alejandro11k/Democracy/README.md

# Democracy
Hardware design files and application software
