alejandro11k/Democracy/software/linux-kernel-patches/README

Apply the patch of the following git/branch

https://github.com/HiassofT/rpi-linux.git (cirrus-4.4.y)

Configure
---------

KERNEL=kernel7
make ARCH=arm CROSS_COMPILE=arm-linux-gnueabihf- bcm2709_morpheus_defconfig

Compile
-------

make ARCH=arm CROSS_COMPILE=arm-linux-gnueabihf- zImage modules dtbs

Install
-------

See https://www.raspberrypi.org/documentation/linux/kernel/building.md
