alejandro11k/Democracy/hardware/board-v1.1/MBoard-BOM.ods

Sheet: MBoard-BOM-v5
Board Qte | 10
CHF / Board | 71.232
€ / Board | 20.74
Estimation / Board | 97.157
A COMMANDER
Designator | Quantity | Total | Comment | Value | Voltage | Footprint | Description | Manufacturer | Manufacturer P/N | Mouser # | Mouser Unit Price | Mouser Total | Farnell # | Farnel Unit Price | Farnell Total | Digikey # | Digikey Unit Price € | Digikey Total €
C4, C47 | 2 | 20 | 220uF | 220uF | 10V | SM/CT_7343_12_D | Tantalum Polymer 40mOhm ESR | Panasonic | 10TPB220ML | 667-10TPB220ML | 1.46 | 29.2
C5, C15, C19, C23, C26, C30, C36 | 7 | 70 | 10uF | 10uF | 35V | SM/C_1206 | Chip Monolithic Ceramic Capacitor | muRata | GRM31CR6YA106KA12L | 81-GRM31CR6YA106KA2L | 0.168 | 11.76
C6, C13 | 2 | 20 | 4.7uF | 4.7uF | 50V | SM/C_1210 | CONDENSATEUR 4.7UF 50V X7R 1210 | KEMET | C1210C475K5RACTU | 80-C1210C475K5RAC | 0.297 | 5.94
D1, D17 | 2 | 20 | B340A |  |  | SM/D_DO214-AC (SMA) | DIODE SCHOTTKY 30V 3A SMA |  |  | 621-B340A-F | 0.328 | 6.56
D2, D3 | 2 | 20 | HSMG-A100-J02J1 | Green | 2,2V | PLCC_2 | SMT LED Green, Single Color PLCC-2 Type | Broadcom/Avago | HSMG-A100-J02J1 | 630-HSMG-A100-J02J1 | 0.275 | 5.5
D4 | 1 | 10 | Diode/A1C2 | 1N4148W |  | SM/D_SOD123-A1C2 | DIODE SWITCH 100V 0.15A | Diodes Inc | 1N4148W-7-F | 621-1N4148W-F | 0.15 | 1.5
D5, D6 | 2 | 20 | APFA3010SEEZGQBDC |  |  | APFA3010 | 3.0x1.0mm RIGHT ANGLE SMD CHIP LED LAMP |  |  | 604-APFA3010SEEZGQBD | 0.891 | 17.82
D7 | 1 | 10 | SMAJ20A-TR | SMAJ20A-TR |  | SM/D_DO214-AC (SMA) | Transil™ diode | STMicroelectronics | SMAJ20A-TR | 511-SMAJ20A-TR | 0.294 | 2.94
D8, D9, D10, D11 | 4 | 40 | SMAJ6.5A-TR | SMAJ6.5A-TR |  | SM/D_DO214-AC (SMA) | Transil™ diode | STMicroelectronics | SMAJ6.5A-TR | 511-SMAJ6.5A-TR | 0.26 | 10.4
D12, D13, D14, D15 | 4 | 40 | SMAJ5.0A-TR | SMAJ5.0A-TR |  | SM/D_DO214-AC (SMA) | Transil™ diode | STMicroelectronics | SMAJ5.0A-TR | 511-SMAJ5.0A | 0.265 | 10.6
D16 | 1 | 10 | APA3010ZGC-GX | Green | 3.3 V | S_1101F_GREEN | SMT LED, 1001F Series, Single Color Right Angle Type (3.0 X 2.0 mm) | Kingbright | APA3010ZGC-GX | 604-APA3010ZGC-GX | 0.372 | 3.72
F1 | 2 | 20 | Fuse | 5x20 4A Fast |  | 5x20 LittelFuse 111 50x | Porte-fusibles, OG ø 5 x 20 mm OG | Schurter | 751.0052 | 693-0751.0052 | 0.143 | 2.86
FB1, FB2 | 2 | 20 | LM21PG221SN1D | 220 Ohm @ 100MHz |  | SM/L_0805 | PERLE DE FERRITE 0805. 220 OHMS/100MHz | Murata | LM21PG221SN1D | 81-BLM21P221SG | 0.074 | 1.48
FC1 | 1 | 10 | Fuse Cartridge 5x20 4A Fast |  |  |  | Cartridge Fuses FSF 5X20 250V 4A | Schurter | 34.1522 | 693-0034.1522 | 0.184 | 1.84
J1 | 1 | 10 | SSM-120-L-DV |  |  | SSM-120 | Mating (female) connector for the RPi 3 |  |  | 649-89898-320LF | 5.29 | 52.9 | 1668272 | 8.7 |  | SAM1146-20-ND | 7.615
J2 | 1 | 10 | TSM-120-01-L-DV |  |  | TSM-120-04-L-DV | Mating (male) connector for the RPi 3 |  |  | 649-95157-140LF | 1.3 | 13 | 1915231 | 1.75
J3 | 1 | 10 | RAPC722X | RAPC722X |  | RAPC722X | DC Power Connectors PCB 2.1MM | SwitchCraft | RAPC722X | 502-RAPC722X | 1.02 | 10.2
J4, J5 | 2 | 20 | MIDI_JACK_5P |  |  | CUI SDS-50J MiniDIN | Connecteur MIDI Jack 5 pôles | CUI | SDS-50J | 490-SDS-50J | 1.04 | 20.8
J6 | 1 | 10 | HEADER_14 |  |  | Male Box Header 2mm 14P | Male Box Header 14 poles | Würth | 625 014 216 21 | 517-957214-6002-AR | 2.08 | 20.8
J7, J12 | 2 | 20 | Jack-3.5mm |  |  | CON_JACK_3.5MM_SMD_Switchcraft_35RASMT2BHNTRX | Connecteur Jack 3.5mm | Switchcraft | 35RASMT2BHNTRX | 502-35RASMT2BHNTRX | 0.78 | 15.6
J8, J9, J10, J11 | 4 | 40 | NSJ12HF-1 |  |  | NSJ12HF-1 | Neutronik 2xJack 6.35 connector |  |  | 568-NSJ12HF-1 | 3.3 | 132
JP1, JP2 | 2 | 20 | HEADER_3 |  |  | BLKCON.100/VH/TM1SQ/W.100/3 | Barrette simple 3 poles 2.54mm | TE Connectivity | 5-826629-0 | 538-22-28-5034 | 0.105 | 2.1
JP3 | 1 | 10 | JUMPER |  |  | BLKCON.100/VH/TM1SQ/W.100/2 | Barrette simple 2 poles 2.54mm | TE Connectivity | 5-826629-0 | 538-22-28-5023 | 0.079 | 0.79
K1 | 1 | 10 | EF2-3NU |  |  | EF2-NU | Miniature Signal Relay |  |  | 551-EF2-3NU | 2.77 | 27.7
L1 | 1 | 10 | 18uH |  |  | BOURNS_1260 | INDUCTOR POWER 18UH 4.2A SMD | Bourns | SRR1260-180M | 652-SRR1260-180M | 0.904 | 9.04
Nut1, Nut2, Nut3, Nut4, Nut5, Nut6, Nut7, Nut8 | 8 | 80 | NRJ-NUT-B |  |  |  | Plastic Nut to fasten 6.35 jack | Neutrik | NRJ-NUT-B | 550-1005 | 0.158 | 12.64
Q3 | 1 | 10 | FDV301N | FDV301N |  | SOT23 | MOSFET N-CH 25V 220MA SOT-23 | Fairchild Semiconductor | FDV301N | 512-FDV301N | 0.154 | 1.54
SW1, SW2 | 2 | 20 | SW_PUSHBUTTON | SPST-NO | 12V | TE Connectivity_SWITCH_SERIES-FSMSM | SWITCH TACTILE SPST-NO 0.05A 12V | TE Connectivity | FSMSM | 506-FSMSMTR | 0.305 | 6.1
U1 | 1 | 10 | MCP23008T-E/SO |  |  | SOIC-18 - W | 8-Bit I/O Expander with Serial Interface (SOIC) |  |  | 579-MCP23008T-E/SO | 1.02 | 10.2
U2 | 1 | 10 | CAT24C32 |  |  | SOIC-8 - N | 32-Kb I2C CMOS Serial EEPROM |  |  | 698-CAT24C32WI-GT3 | 0.375 | 3.75
U3 | 1 | 10 | TPS5431 | TPS5431 |  | SOIC-8 - N - Power Pad | IC REG BUCK ADJ 3A 8SO | Texas Instruments | TPS5431DDAR | 595-TPS5431DDAR | 3.72 | 37.2
U4 | 1 | 10 | LP2989IMX-3.3 | LP2989MX-3.3 |  | SOIC-8 - N | LP2989 500mA Linear Voltage Regulator for Digital Applications | Texas Instruments | LP2989IMX-3.3/NOPB | 926-LP2989IMX33NOPB | 2.11 | 21.1
U5 | 1 | 10 | TLV70212DBV | TLV70212DBV |  | SOT23-5 | Régulateur LDO +1.2V, 300mA | Texas Instruments | TLV70212DBV | 595-TLV70212DBVR | 0.453 | 4.53
U6 | 1 | 10 | XC6SLX9-2TQG144C | XC6SLX9-2TQG144C |  | TQFP-144 | XC2C256 Spartan-6 LX 1.2V FPGA, 102 User I/Os, 144-Pin TQFP (0.5mm Pitch), Speed Grade 2, Commercial Grade, Pb-FreeCoolRunner-II CPLD 256-BGA | Xilinx | XC6SLX9-2TQG144C | NA |  | 0 | 1876228 | 41.2 |  | 122-1745-ND | 14.6 | 146
U7 | 1 | 10 | 6N138S | 6N138S |  | SDIP-8 | High Speed Optocoupler | Vishay | 6N138S | 859-6N138S | 0.462 | 4.62
U8 | 1 | 10 | TL750L08CD | TL750L08CD |  | SOIC-8 - N | Régulateur LDO +8.0V, 150mA | Texas Instruments | TL750L08CD | 595-TL750L08CDR | 0.525 | 5.25
U9 | 1 | 10 | XCF04S | XCF04SVOG20C |  | TSSOP-20 | Platform Flash In-System Programmable Configuration PROMs | Xilinx | XCF04SVOG20C | NA |  | 0 | 1605850 | 11.75 |  | 122-1288-5-ND | 6.14 | 61.4
U10 | 1 | 10 | SN74AHCT1G125DBVR | SN74AHCT1G125 |  | SOT23-5 | Buffers & Line Drivers Tri-State Single Bus | Texas Instruments | SN74AHCT1G125DBVR | 595-SNAHCT1G125DBVR | 0.282 | 2.82
U11 | 1 | 10 | MAX11644EUA+ |  |  | uMAX-8 | ADC 12Bit I2C |  |  | 700-MAX11644EUA+ | 1.4 | 14
U12 | 1 | 10 | ADG2188 |  |  | VFQFN-32_(32-Lead LFCSP_VQ) | Switch 8x8 |  |  | 584-ADG2188BCPZ-R7 | 8.58 | 85.8
U13 | 1 | 10 | MCP4561-103E/MS |  |  | MSOP-8 | I2C Digital pot 10K |  |  | 579-MCP4561-103E/MS | 0.956 | 9.56
U14 | 1 | 10 | TCA9406DCU |  |  | VSSOP-8 | I2C Voltage level translator |  |  | 595-TCA9406DCUR | 0.9 | 9
U15 | 1 | 10 | MCP4561-503E/MS |  |  | MSOP-8 | I2C Digital pot 50K |  |  | 579-MCP4561-503E/MS | 0.956 | 9.56
U16, U17 | 2 | 20 | NCP5623DTBR2G |  |  | TSSOP-14 | Triple Output I2C Controlled RGB LED Driver |  |  | 863-NCP5623DTBR2G | 1.25 | 25
U18 | 1 | 10 | PCA9543APW |  |  | TSSOP-14 | 2-Channel I2C Bus Switch With Interrupt Logic and Reset |  |  | 595-PCA9543APWR | 1.27 | 12.7
Y1 | 1 | 10 | OSCILLATOR_2 | 24MHz | 3.3V | ABRACON_OSCILLATOR_ASFL1 SERIES | Oscillateur SMD 5mmx3.2mmx0.85mm | ABRACON Corporation | ASFL1-24.000MHZ-EK-T | 815-ASFL1-24.0-EC-T | 1.99 | 19.9
 |  |  |  |  |  |  |  |  |  | Total Price |  | 712.32 |  |  | 0 |  |  | 207.4
 |  |  |  |  |  |  |  |  |  | Price / Board |  | 71.232 |  |  | 0 |  |  | 20.74
PASSIF → Assemtron
C1, C2, C7, C16, C17, C18, C20, C21, C22, C24, C25, C27, C28, C29, C31, C32, C33, C34, C35, C37, C38, C39, C40, C41, C42, C44, C45, C46, C48, C49, C50, C51, C53, C54, C55, C56, C70, C71 | 38 | 380 | 100nF | 100nF | 16V | SM/C_0603 | Ceramic multi-layer | AVX | 0603YC104KAZ2A | 81-GRM39X104K50D | 0.013 | 4.94
C3, C14 | 2 | 20 | 10nF | 10nF | 50V | SM/C_0603 | Ceramic multi-layer, Capacitor, ceramic | AVX, Kemet | 06035C103KAZ2A, C0603C103J5RAC-TU | 81-GRM39X103K50D | 0.01 | 0.2
C8, C52 | 2 | 20 | 4.7uF | 4.7uF | 6.3V | SM/C_0805 | Ceramic multi-layer | muRata | GRM219R60J475KE19D | 81-GRM21BR61E475KA12 | 0.076 | 1.52
C9, C11 | 2 | 20 | 2.2uF | 2.2uF | 16V | SM/C_0805 | Ceramic Chip Capacitor | Kemet | C0805C225K4RAC | 81-GRM219R61H225KE5D | 0.084 | 1.68
C10, C43 | 2 | 20 | 22uF | 22uF | 6.3 | SM/C_0805 | Ceramic multi-layer | Kemet | C0805C226M9PAC7800 | 81-GRM21R60J226ME39L | 0.1 | 2
C12 | 1 | 10 | 10nF | 10nF | 50V | SM/C_0805 | Ceramic Chip Capacitor | Kemet | C0805C103K5RAC | 80-C0805C103K5RACTM | 0.044 | 0.44
C57, C58, C59, C60 | 4 | 40 | 1uF | 1uF | 10V | SM/C_0603 | Ceramic multi-layer | MURATA | GRM188R61A105KA61D | 81-GRM39R105K10 | 0.019 | 0.76
C61 | 1 | 10 | 100nF | 100nF | 50V | SM/C_0805 | Ceramic Chip Capacitor | Kemet | C0805C104K5RAC7800 | 81-GRM40X103K50D | 0.017 | 0.17
C62, C63, C64, C65, C66, C67, C68, C69 | 8 | 80 | 22pF | 22pF | 50V | SM/C_0603 | Capacitor, ceramic | Kemet | C0603C220J5GAC | 80-C0603C220J5G | 0.022 | 1.76
R2, R4, R60, R61, R62, R63 | 6 | 60 | 3K9 | 3K9 | 50V | SM/R_0603 | Résistance 0603 63mW 1% 3K9 | Multicomp | MC 0.036mW 0603 1% 3K9 | 667-ERJ-3EKF3901V | 0.015 | 0.9
R5 | 1 | 10 | 1K | 1K | 50V | SM/R_0603 | Résistance 0603 63mW 1% 1K | Multicomp | MC 0.036mW 0603 1% 1K | 667-ERJ-3EKF1001V | 0.014 | 0.14
R6, R12, R13, R26, R27, R28, R44, R50 | 8 | 80 | 10K | 10K | 50V | SM/R_0603 | Résistance 0603 63mW 1% 10K | Multicomp | MC 0.036mW 0603 1% 10K | 667-ERJ-3EKF1002V | 0.014 | 1.12
R7 | 1 | 10 | 3.24K | 3.24K | 75V | SM/R_0603 | Résistance 0603 100mW 1% 3.24K | Panasonic | ERJ-3EKF3241V | 667-ERJ-3EKF3241V | 0.015 | 0.15
R8 | 1 | 10 | 330K | 330K | 50V | SM/R_0603 | Résistance 0603 63mW 1% 330K | Multicomp | MC 0.036mW 0603 1% 330K | 667-ERJ-3EKF3303V | 0.015 | 0.15
R9, R23 | 2 | 20 | 33R | 33R | 50V | SM/R_0603 | Résistance 0603 63mW 1% 33R | Multicomp | MC 0.036mW 0603 1% 33R | 667-ERJ-3EKF33R0V | 0.015 | 0.3
R10, R11 | 2 | 20 | 110R | 110R | 50V | SM/R_0603 | Résistance 0603 63mW 1% 110R | Multicomp | MC 0.036mW 0603 1% 110R | 667-ERJ-3EKF1100V | 0.014 | 0.28
R35, R36, R37, R38, R39, R40, R41, R42 | 8 | 80 | 0R | 0R | 75V | SM/R_0603 | Résistance 0603 100mW 1% 0R | VISHAY DRALORIC | CRCW06030000Z0EA | 71-CRCW0603-0-E3 | 0.023 | 1.84
R18, R19, R20 | 3 | 30 | 220R | 220R | 50V | SM/R_0603 | Résistance 0603 63mW 1% 220R | Multicomp | MC 0.036mW 0603 1% 220R | 667-ERJ-3EKF2200V | 0.015 | 0.45
R21, R22, R33, R34, R43, R49, R51, R52, R53, R54 | 10 | 100 | 100R | 100R | 50V | SM/R_0603 | Résistance 0603 63mW 1% 100R | Multicomp | MC 0.036mW 0603 1% 100R | 667-ERJ-3EKF1000V | 0.009 | 0.9
R24, R25 | 2 | 20 | 4K7 | 4K7 | 50V | SM/R_0603 | Résistance 0603 63mW 1% 4K7 | Multicomp | MC 0.036mW 0603 1% 4K7 | 667-ERJ-3EKF4701V | 0.015 | 0.3
R29, R30, R47, R48, R57 | 5 | 50 | 100K | 100K | 50V | SM/R_0603 | Résistance 0603 63mW 1% 100K | Multicomp | MC 0.036mW 0603 1% 100K | 667-ERJ-3EKF1003V | 0.014 | 0.7
R31, R32 | 2 | 20 | 57k6 | 57k6 | 75V | SM/R_0603 | Résistance 0603 100mW 1% 57k6 | Panasonic | ERJ-3EKF5762V | 667-ERJ-3EKF5762V | 0.015 | 0.3
R45, R46 | 2 | 20 | 200R | 200R | 50V | SM/R_0603 | Résistance 0603 63mW 1% 200R | Multicomp | MC 0.036mW 0603 1% 200R | 667-ERJ-3EKF2000V | 0.014 | 0.28
R55 | 1 | 10 | 150R | 150R | 50V | SM/R_0603 | Résistance 0603 63mW 1% 150R | Multicomp | MC 0.036mW 0603 1% 150R | 667-ERJ-3EKF1500V | 0.014 | 0.14

Sheet: Mouser
667-10TPB220ML | 20
81-GRM31CR6YA106KA2L | 70
80-C1210C475K5RAC | 20
621-B340A-F | 10
630-HSMG-A100-J02J1 | 20
621-1N4148W-F | 10
604-APFA3010SEEZGQBD | 20
511-SMAJ20A-TR | 10
511-SMAJ6.5A-TR | 40
511-SMAJ5.0A | 40
604-APA3010ZGC-GX | 10
693-0751.0052 | 20
81-BLM21P221SG | 20
693-0034.1522 | 10
649-89898-320LF | 10
649-95157-140LF | 10
502-RAPC722X | 10
490-SDS-50J | 20
517-957214-6002-AR | 10
502-35RASMT2BHNTRX | 20
568-NSJ12HF-1 | 40
538-22-28-5034 | 20
538-22-28-5023 | 10
551-EF2-3NU | 10
652-SRR1260-180M | 10
550-1005 | 80
512-FDV301N | 10
506-FSMSMTR | 20
579-MCP23008T-E/SO | 10
698-CAT24C32WI-GT3 | 10
595-TPS5431DDAR | 10
926-LP2989IMX33NOPB | 10
595-TLV70212DBVR | 10
859-6N138S | 10
595-TL750L08CDR | 10
595-SNAHCT1G125DBVR | 10
700-MAX11644EUA+ | 10
584-ADG2188BCPZ-R7 | 10
579-MCP4561-103E/MS | 10
595-TCA9406DCUR | 10
579-MCP4561-503E/MS | 10
863-NCP5623DTBR2G | 20
595-PCA9543APWR | 10
815-ASFL1-24.0-EC-T | 10
