alejandro11k/Democracy/hardware/altium/3D/APFA3010.STEP

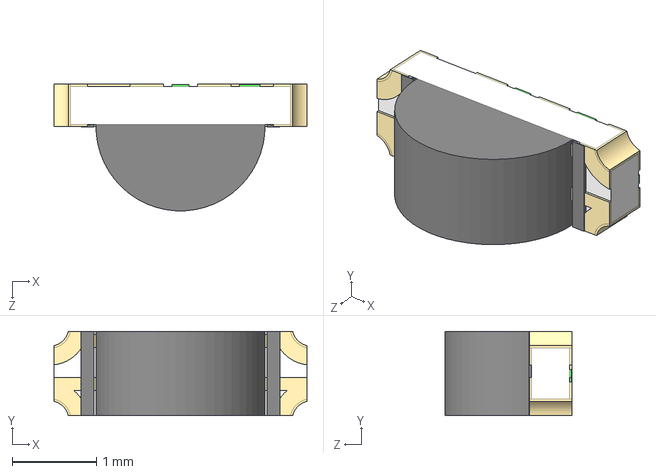
[picture p6: CAD file, 2016-10-30]
hardware/altium/3D/APFA3010.STEP
3.00 x 1.00 x 1.50 mm
