alejandro11k/Democracy/hardware/components/connectors/Jack/3D+File+NMJ6HFD2.stp

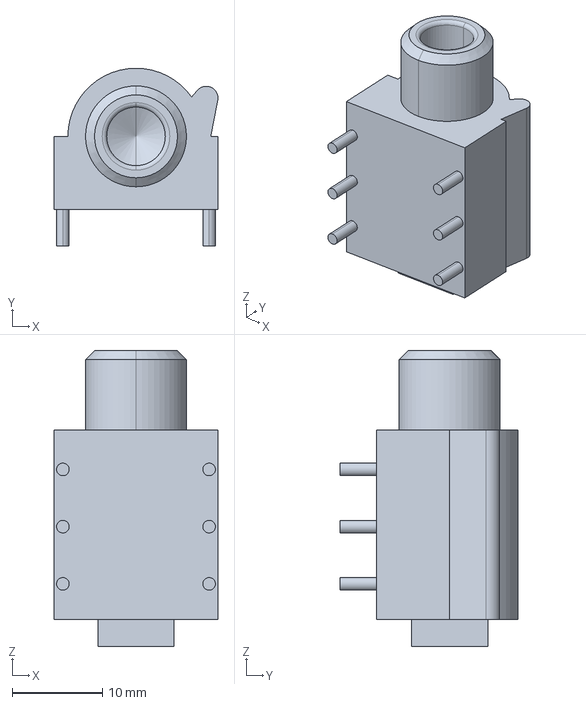
[picture p7: CAD file, 2016-10-30]
hardware/components/connectors/Jack/3D+File+NMJ6HFD2.stp
18.2 x 19.7 x 32.9 mm
