alejandro11k/Democracy/hardware/components/connectors/samtec/HLE-120/HLE-120-02-L-DV.stp

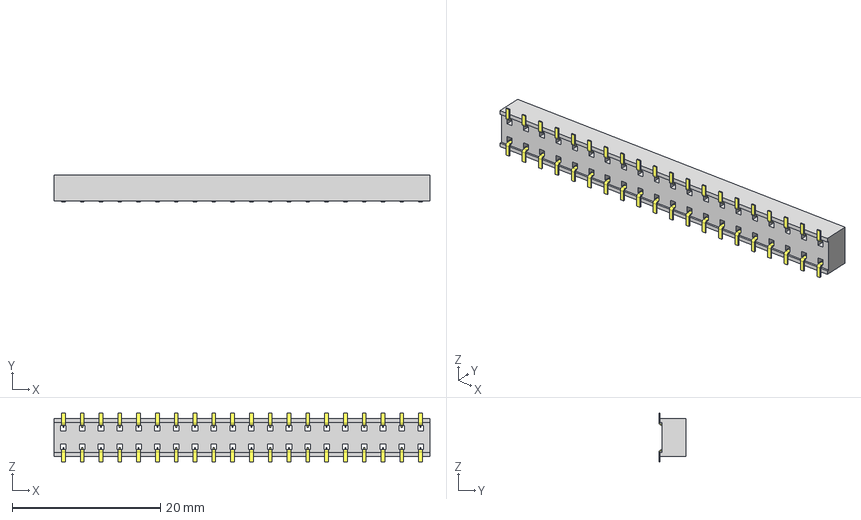
[picture p8: CAD file, 2016-10-30]
hardware/components/connectors/samtec/HLE-120/HLE-120-02-L-DV.stp
50.8 x 3.66 x 6.58 mm
_HLE-120-02-DV_socket
_C-132-12-20-DV
