alejandro11k/Democracy/hardware/components/connectors/samtec/SMT-120/TSM-120-04-L-DV.stp

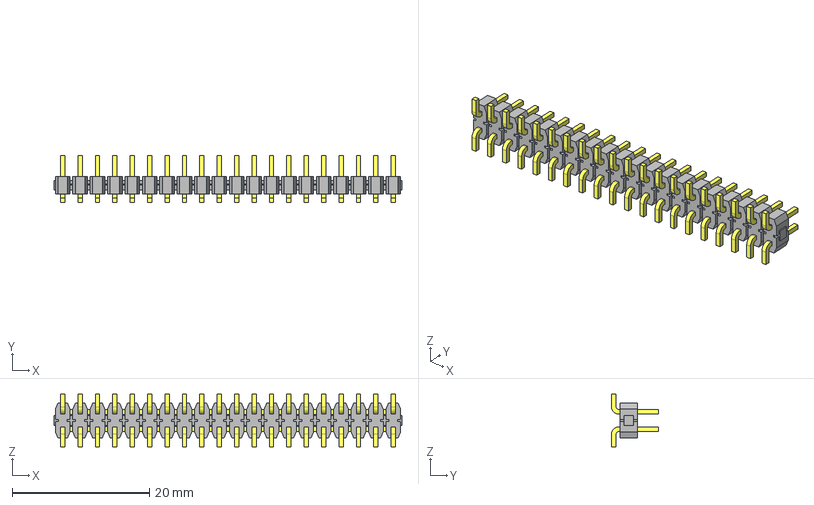
[picture p9: CAD file, 2016-10-30]
hardware/components/connectors/samtec/SMT-120/TSM-120-04-L-DV.stp
50.8 x 6.86 x 7.70 mm
_TSM-120-04-L-DV_body
_T-1S6-21(-04-20-DV)
