alejandro11k/Democracy/hardware/components/connectors/Jack/3D+File+NSJ12HF-1.stp

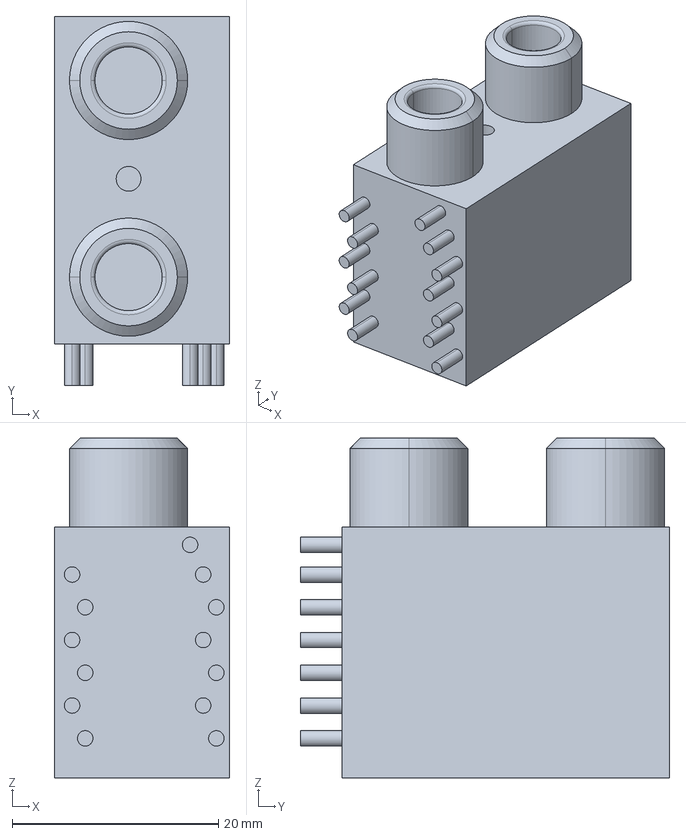
[picture p12: CAD file, 2016-10-30]
hardware/components/connectors/Jack/3D+File+NSJ12HF-1.stp
17.0 x 35.8 x 32.9 mm
