alejandro11k/Democracy/hardware/components/connectors/Jack/3D+File+NRJ6HM-1.stp

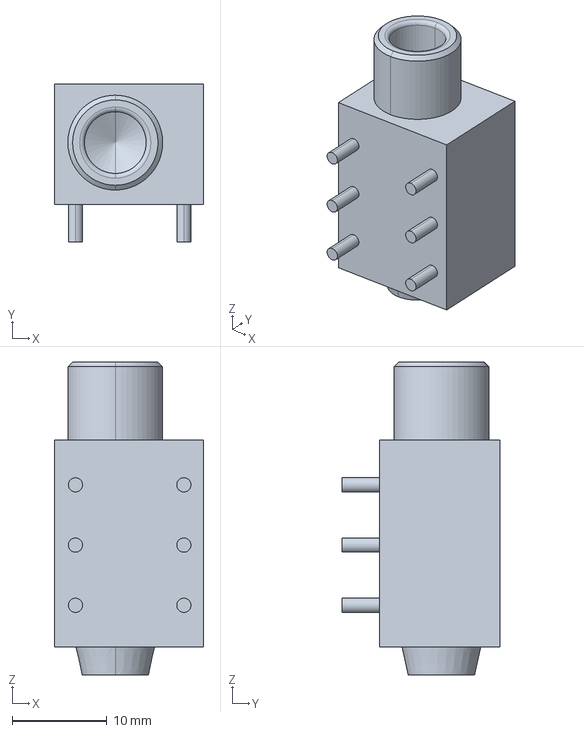
[picture p13: CAD file, 2016-10-30]
hardware/components/connectors/Jack/3D+File+NRJ6HM-1.stp
15.8 x 16.7 x 33.0 mm
