alejandro11k/Democracy/hardware/altium/Models/84686100_ABPH-1680-0100.stp

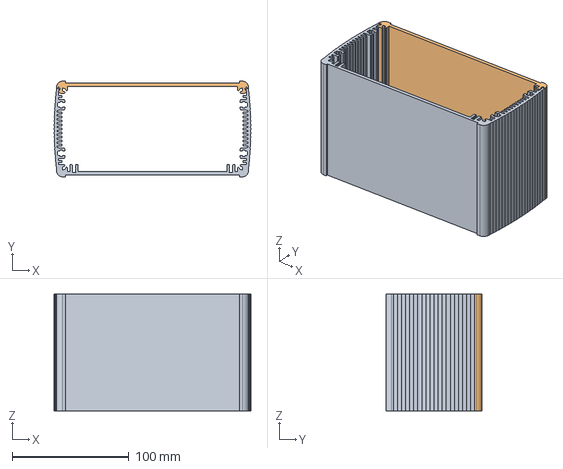
[picture p14: CAD file, 2016-10-30]
hardware/altium/Models/84686100_ABPH-1680-0100.stp
169.0 x 82.0 x 100.0 mm
ABPH 1680 UT_1008071_3DSYM
ABPH 1680 OT_1008076_3DSYM
