alejandro11k/Democracy/hardware/altium/Models/84168100_ABD-1680.stp

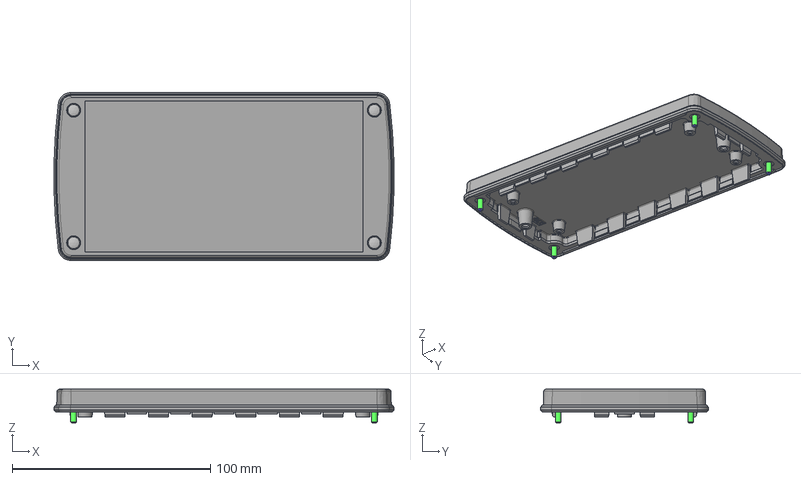
[picture p15: CAD file, 2016-10-30]
hardware/altium/Models/84168100_ABD-1680.stp
171.4 x 84.6 x 17.1 mm
ABD 1680_1009800_3D
DI 1680_1008097_3DSYM
1009410_3D x 4
SHR Z KT30X10 WN 1452 OG_3DSYM x 4
