alejandro11k/Democracy/(list of files, cad)

Other CAD files:
hardware/components/enclosures/Bopla/84686100_ABPH-1680-0100.dxf
