alejandro11k/Democracy/hardware/board-v1.1/MBoard-SCH.PDF

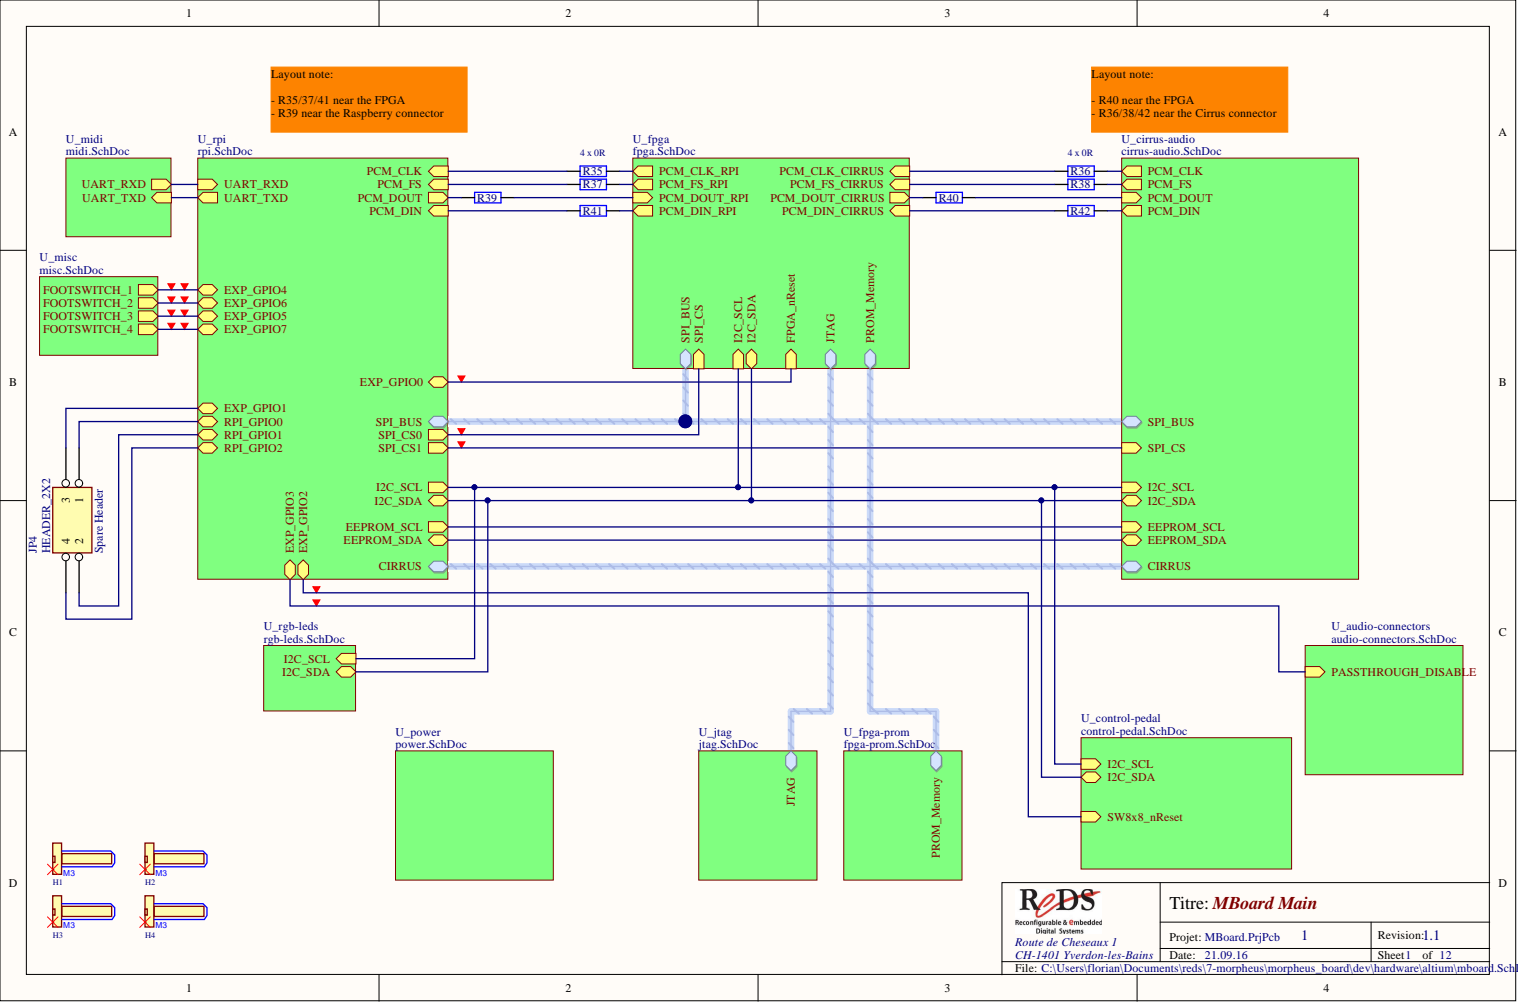
[picture p16: page 1]

- R35/37/41 near the FPGA
- R39 near the Raspberry connector

- R40 near the FPGA
- R36/38/42 near the Cirrus connector

R35 | R36
R37 | R38

Route de Cheseaux 1 CH-1401 Yverdon-les-Bains | Titre: MBoard Main

Projet: MBoard.PrjPcb 1 | Revision: 1.1

Date: 21.09.16 | Sheet 1 of 12

C:\Users\florian\Documents\reds\7-morpheus\morpheus_board\dev\hardware\altium\mboard.SchDoc

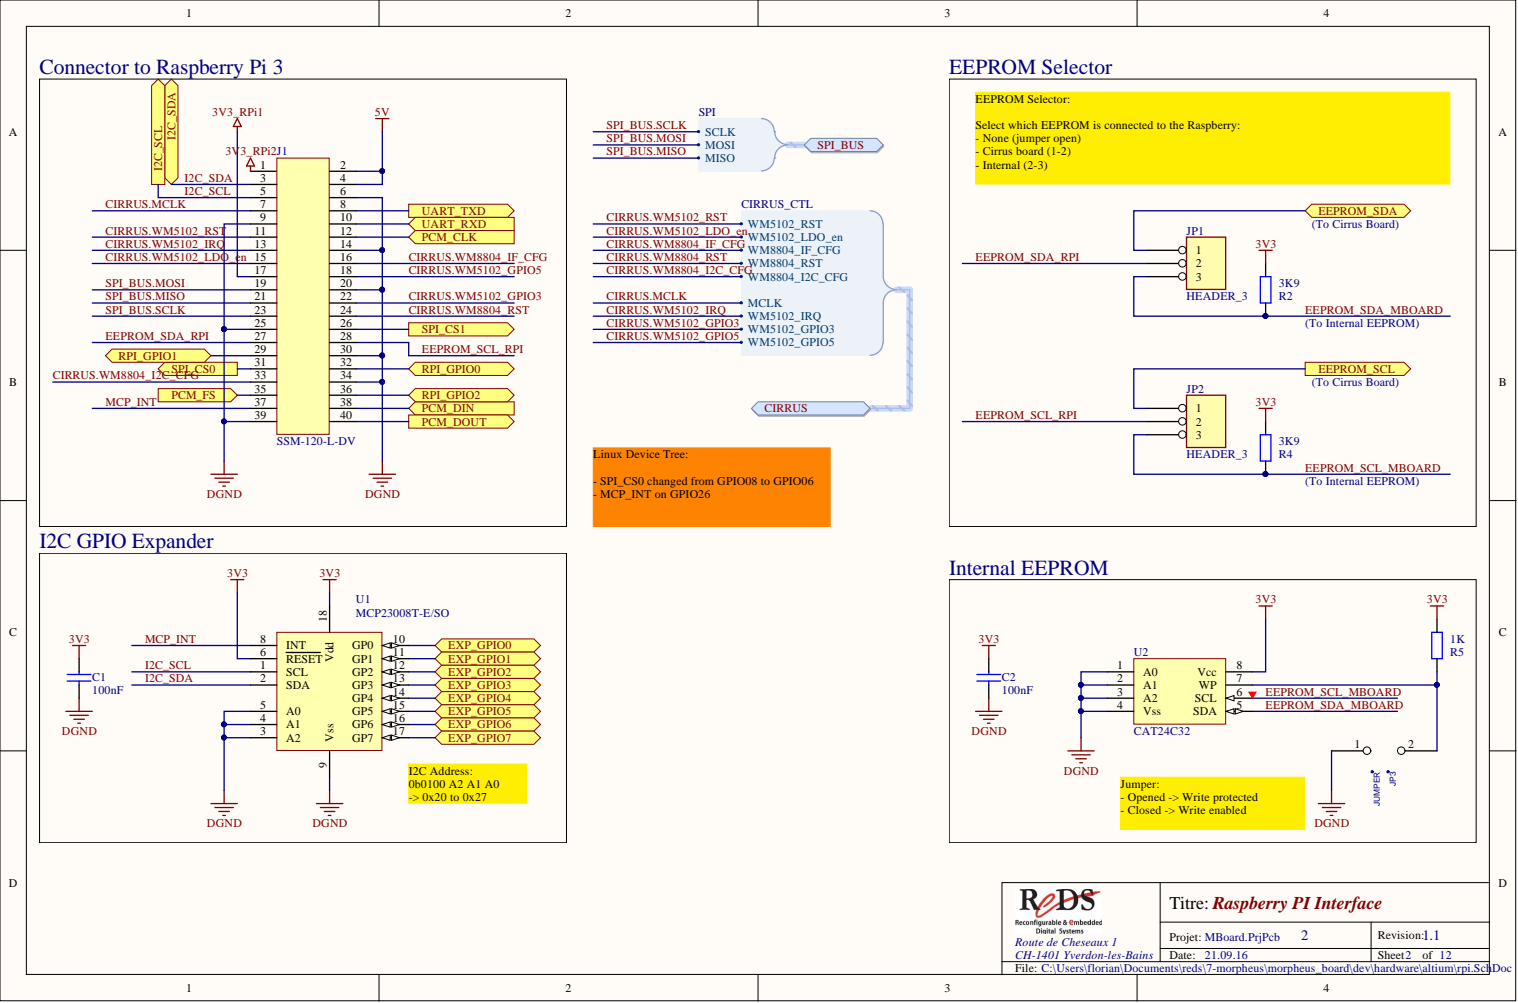
[picture p17: page 2]

Connector to Raspberry Pi 3

Select which EEPROM is connected to the Raspberry:
- None (jumper open)
- Cirrus board (1-2)
- Internal (2-3)

I2C_SCL | 5 | 6

C:\Users\florian\Documents\reds\7-morpheus\morpheus_board\dev\hardware\altium\rpi.SchDoc

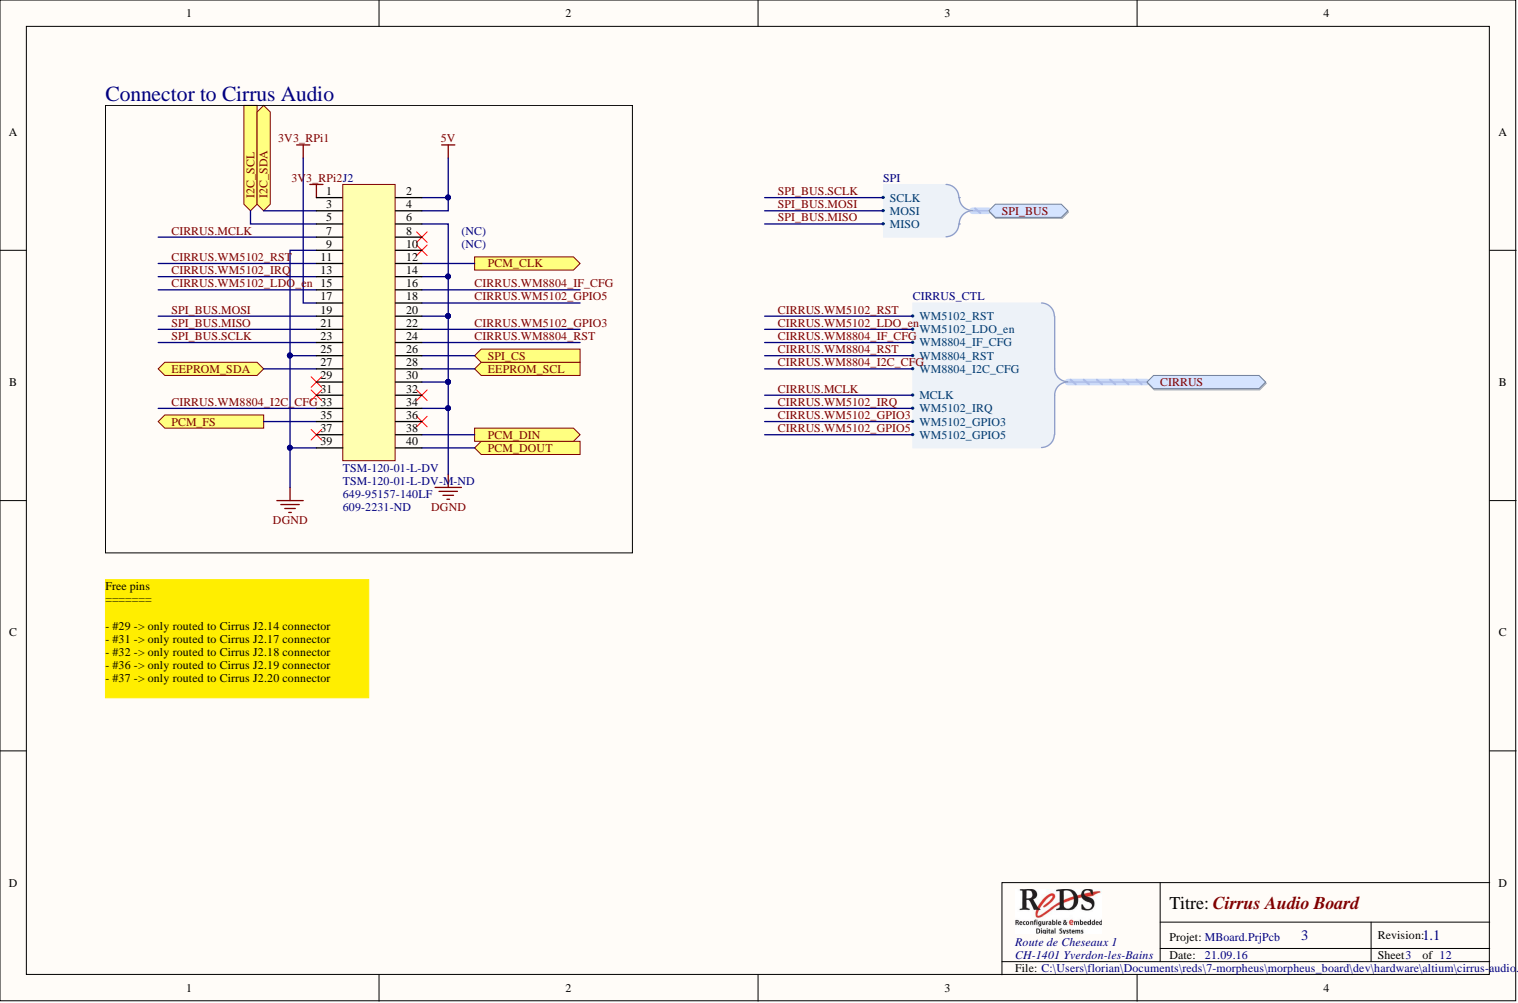
[picture p18: page 3]

nector to Cirrus Au

7 9 | | 8

3 1 | | 3 2
3 3 3 5 3 7 | | 3 4

R o u te de Chesea ux 1 CH-1 1 Yverd o n-les-B a i n s | Cirrus Audio Bo ard

Projet : MBoard.PrjPcb | Rev i s i o n : 1.1

1.0 9.1 | Sheet o f

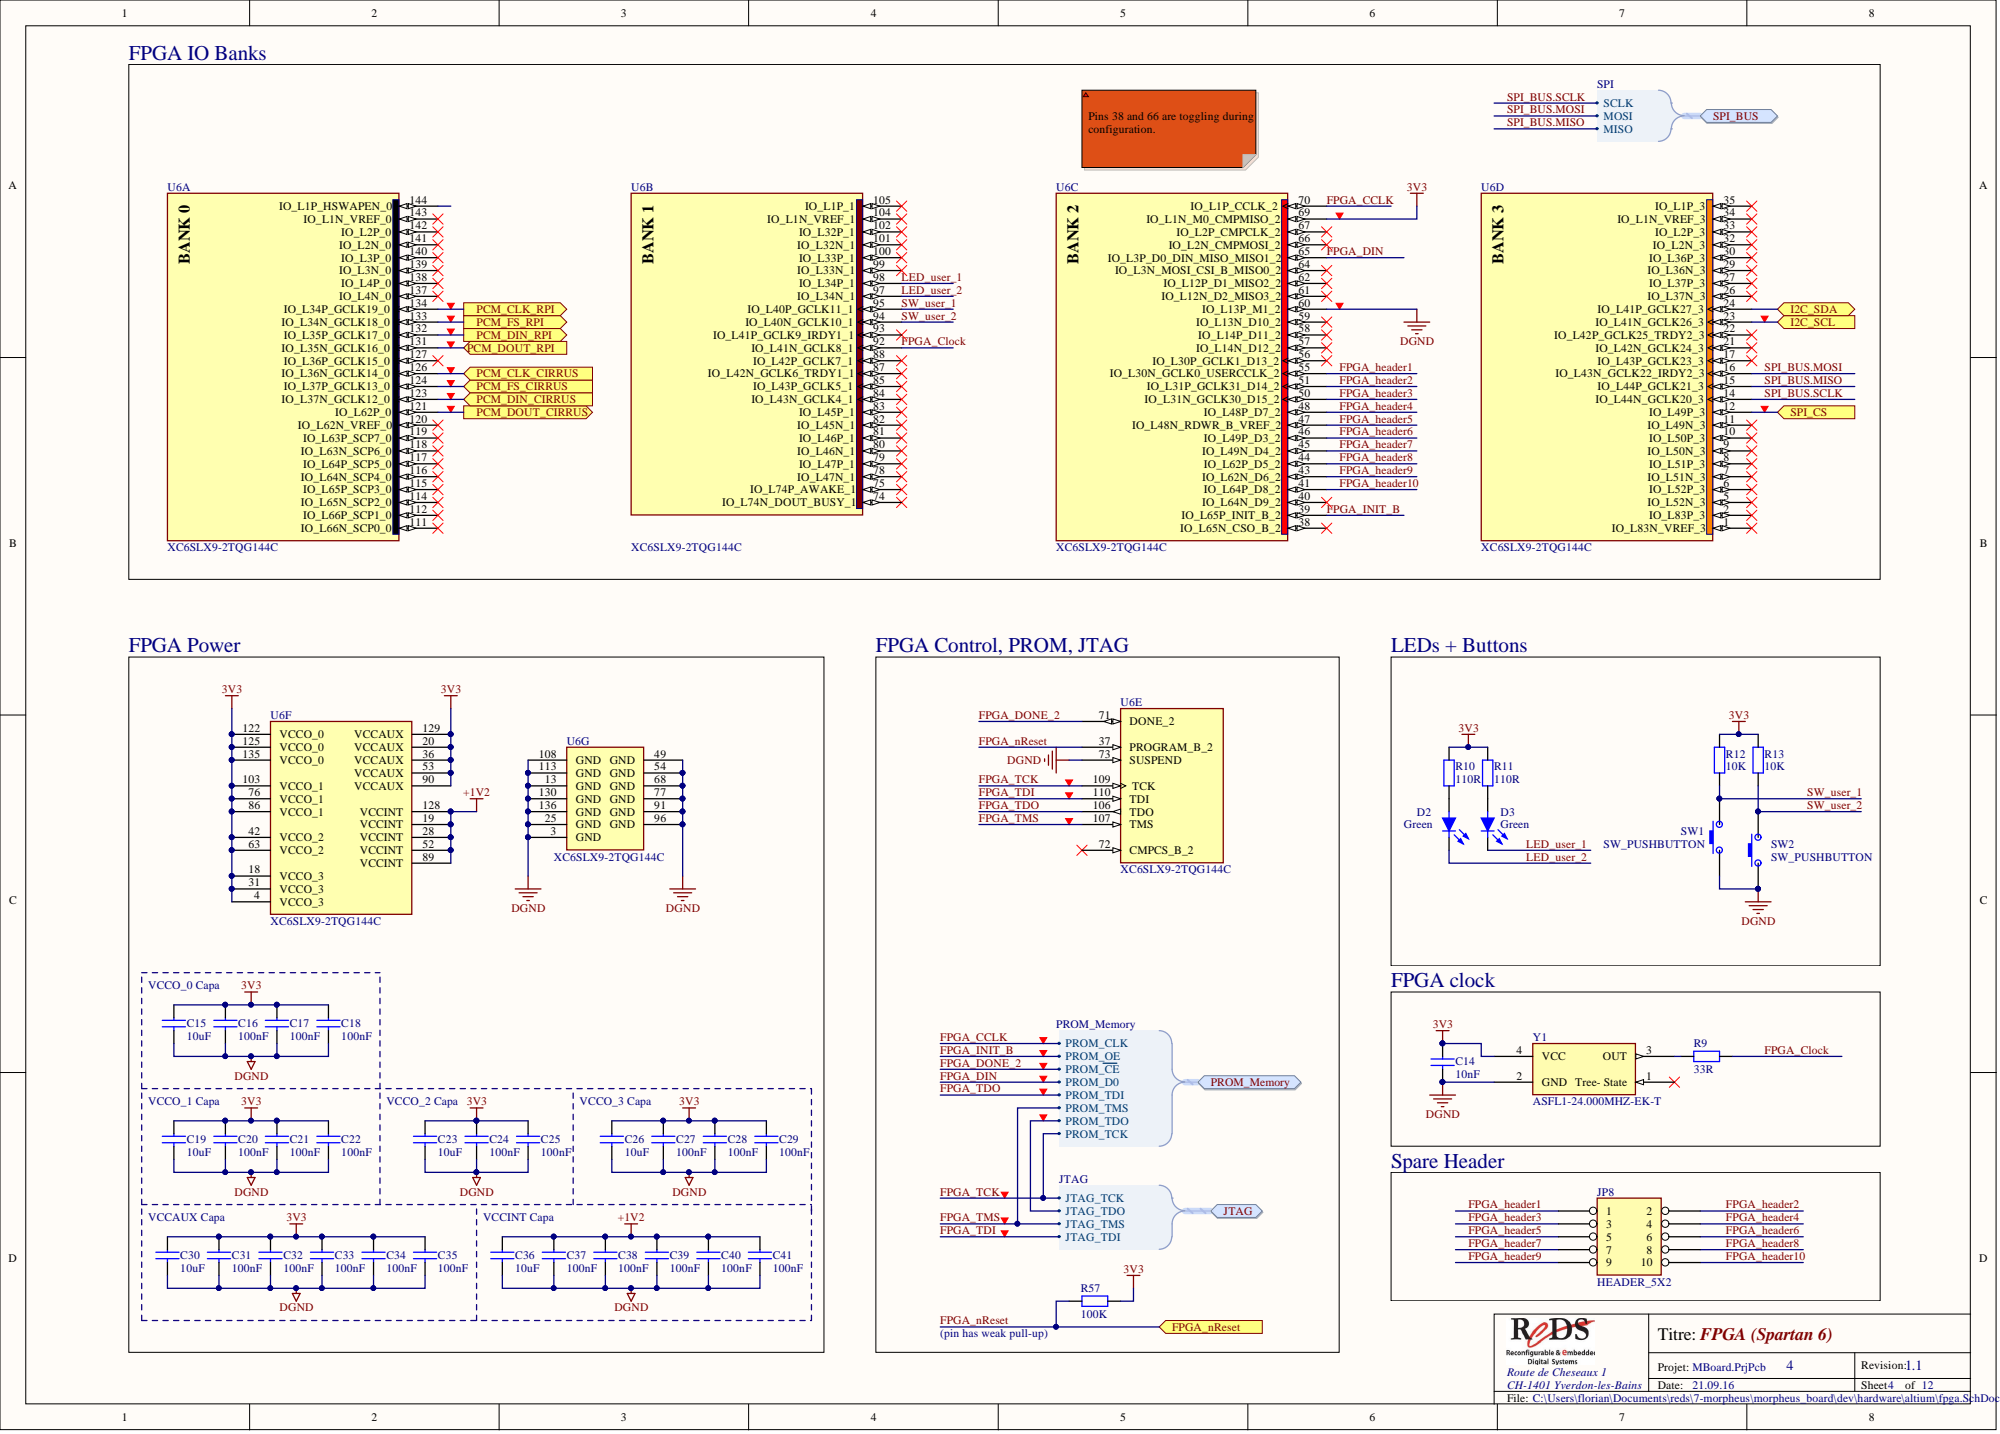
[picture p19: page 4]

Pins 38 and 66 are toggling during
configuration.

FPGA_nReset
(pin has weak pull-up)

C:\Users\florian\Documents\reds\7-morpheus\morpheus_board\dev\hardware\altium\fpga.SchDoc

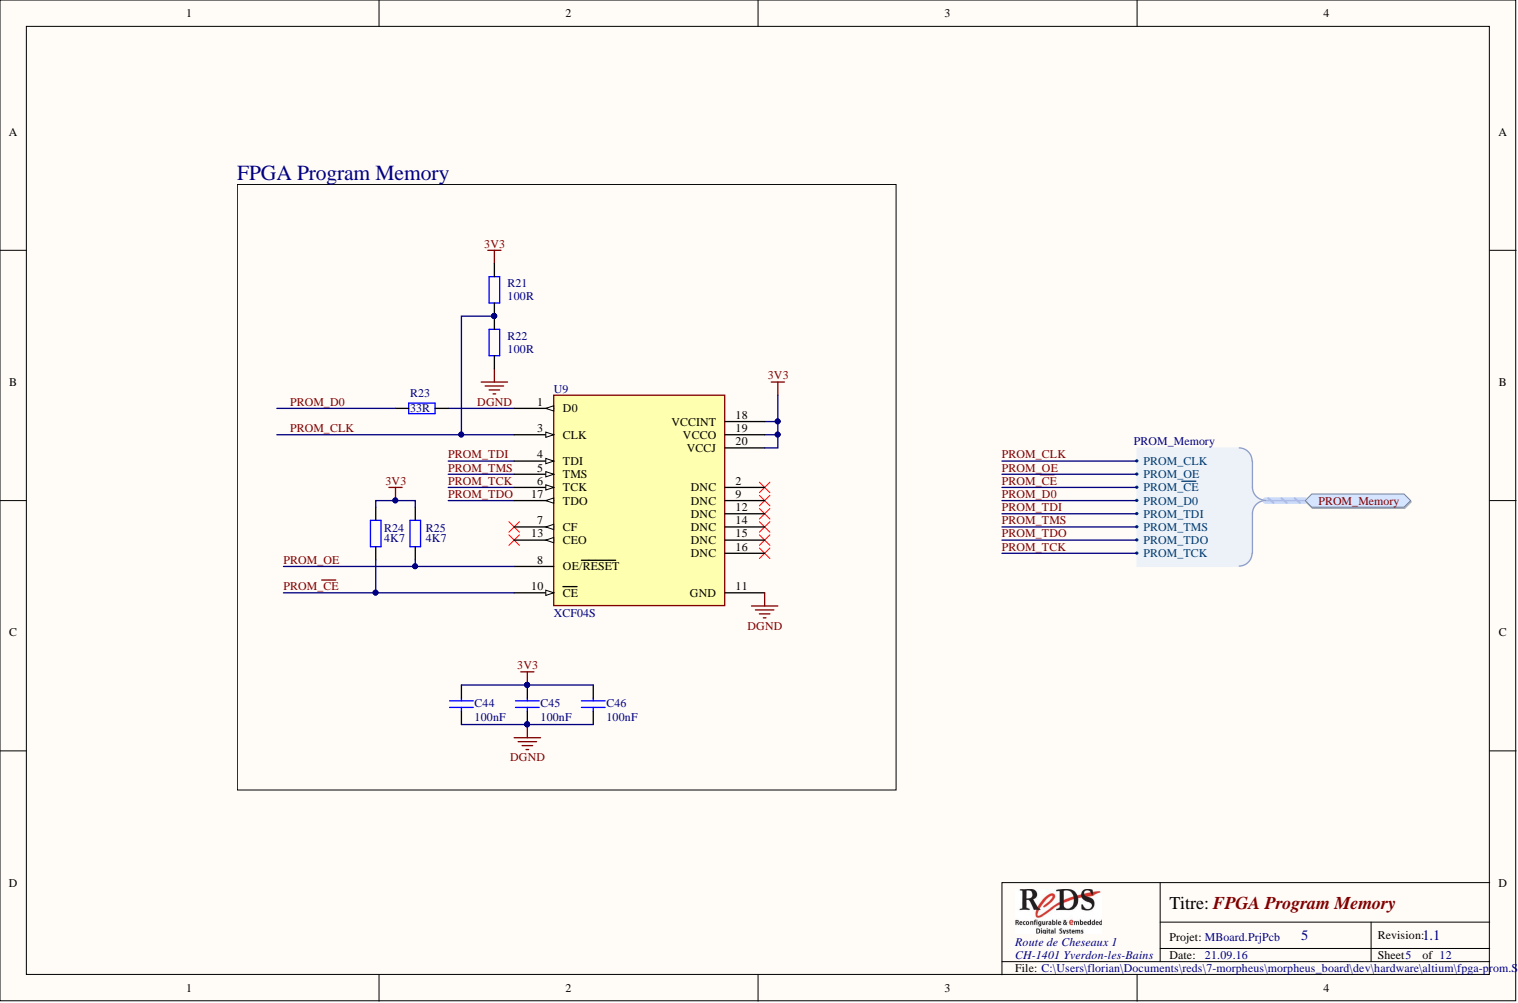
[picture p20: page 5]

1 9
2 0

R o u te de Chesea ux 1 CH-1 1 Yverd o n-les-B a i n s | FPGA Pro gram Memory 5

Projet : MBoard.PrjPcb | Rev i s i o n : 1.1

1.0 9.1 | Sheet o f

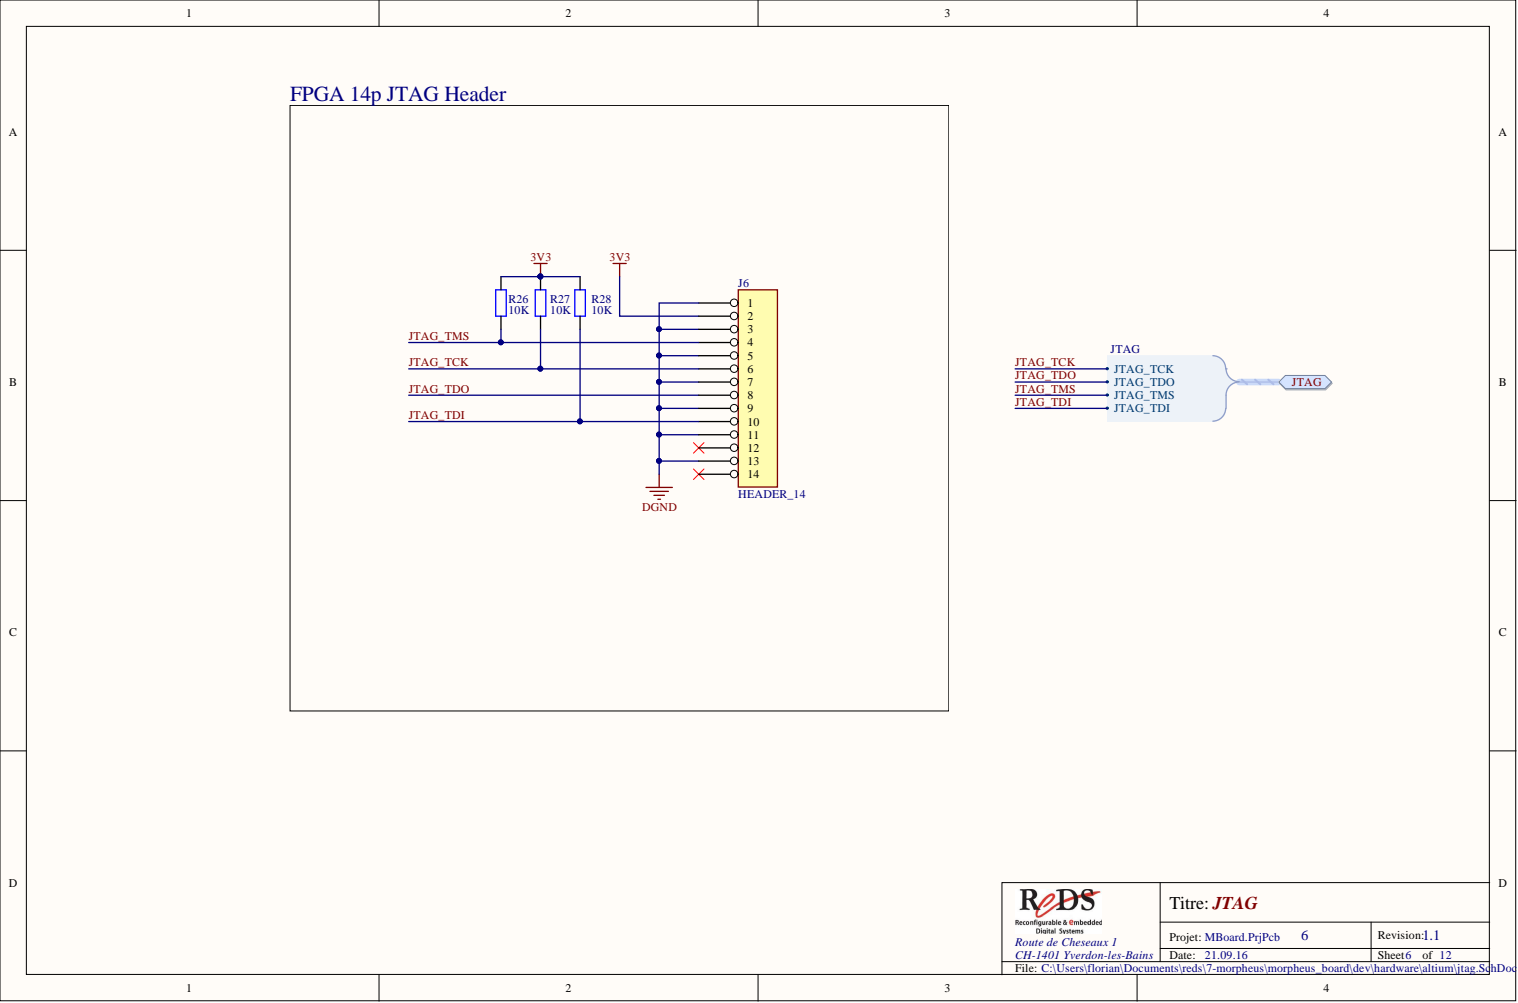
[picture p21: page 6]

R o u te de Chesea ux 1 CH-1 1 Yverd o n-les-B a i n s | JTAG

Projet : MBoard.PrjPcb | Rev i s i o n : 1.1

1.0 9.1 | Sheet o f

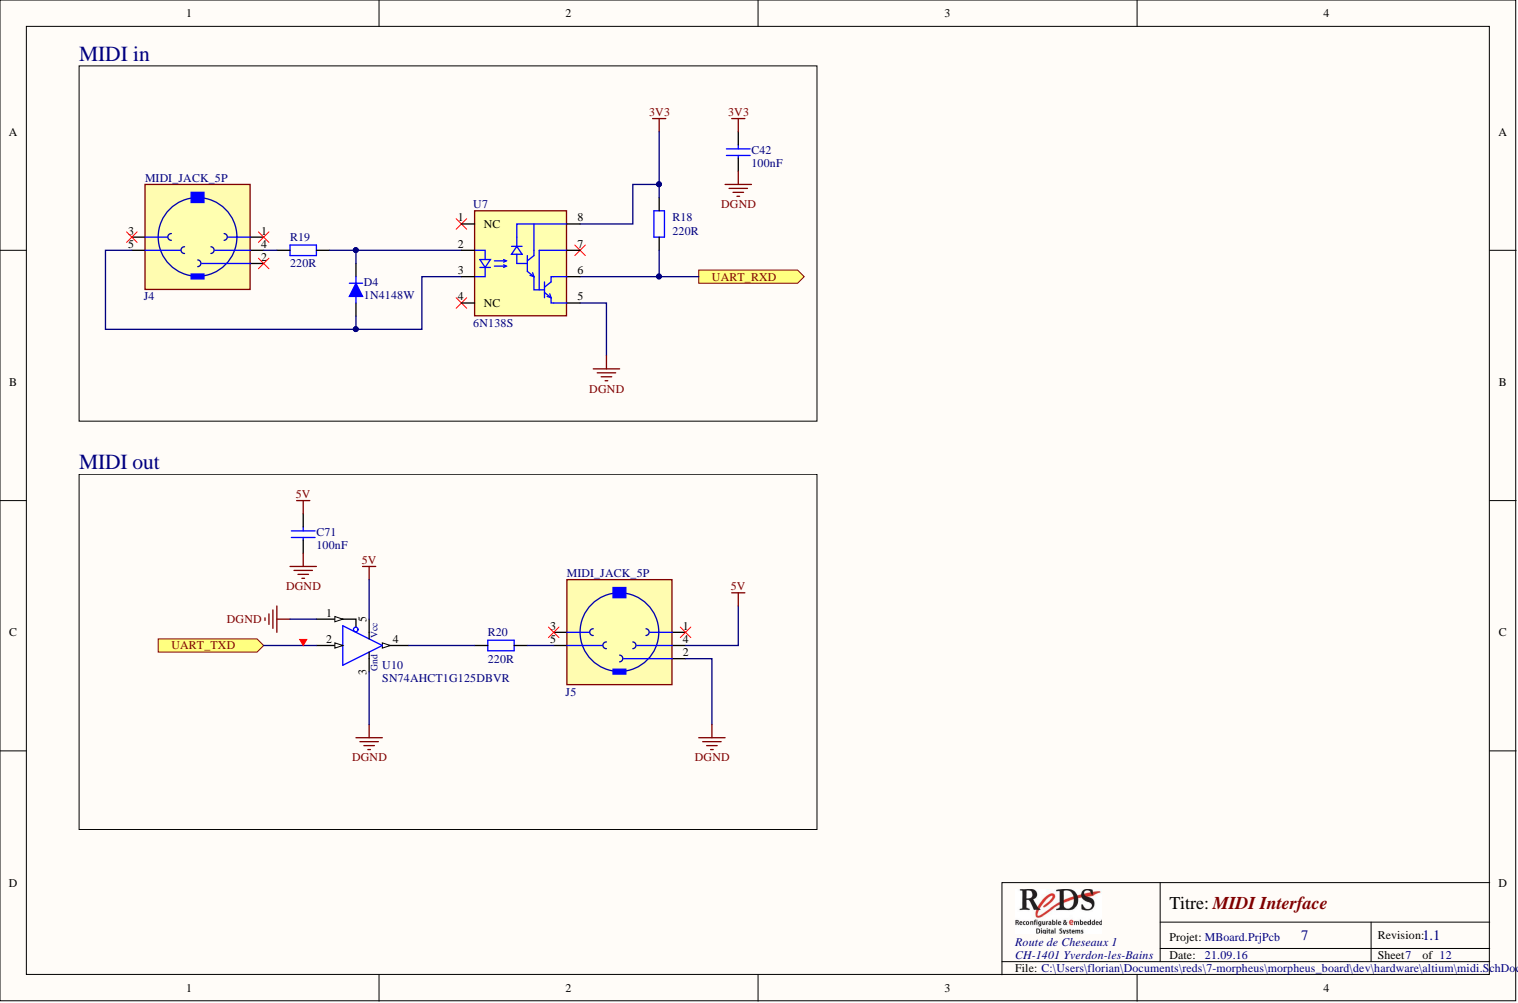
[picture p22: page 7]

C:\Users\florian\Documents\reds\7-morpheus\morpheus_board\dev\hardware\altium\midi.SchDoc

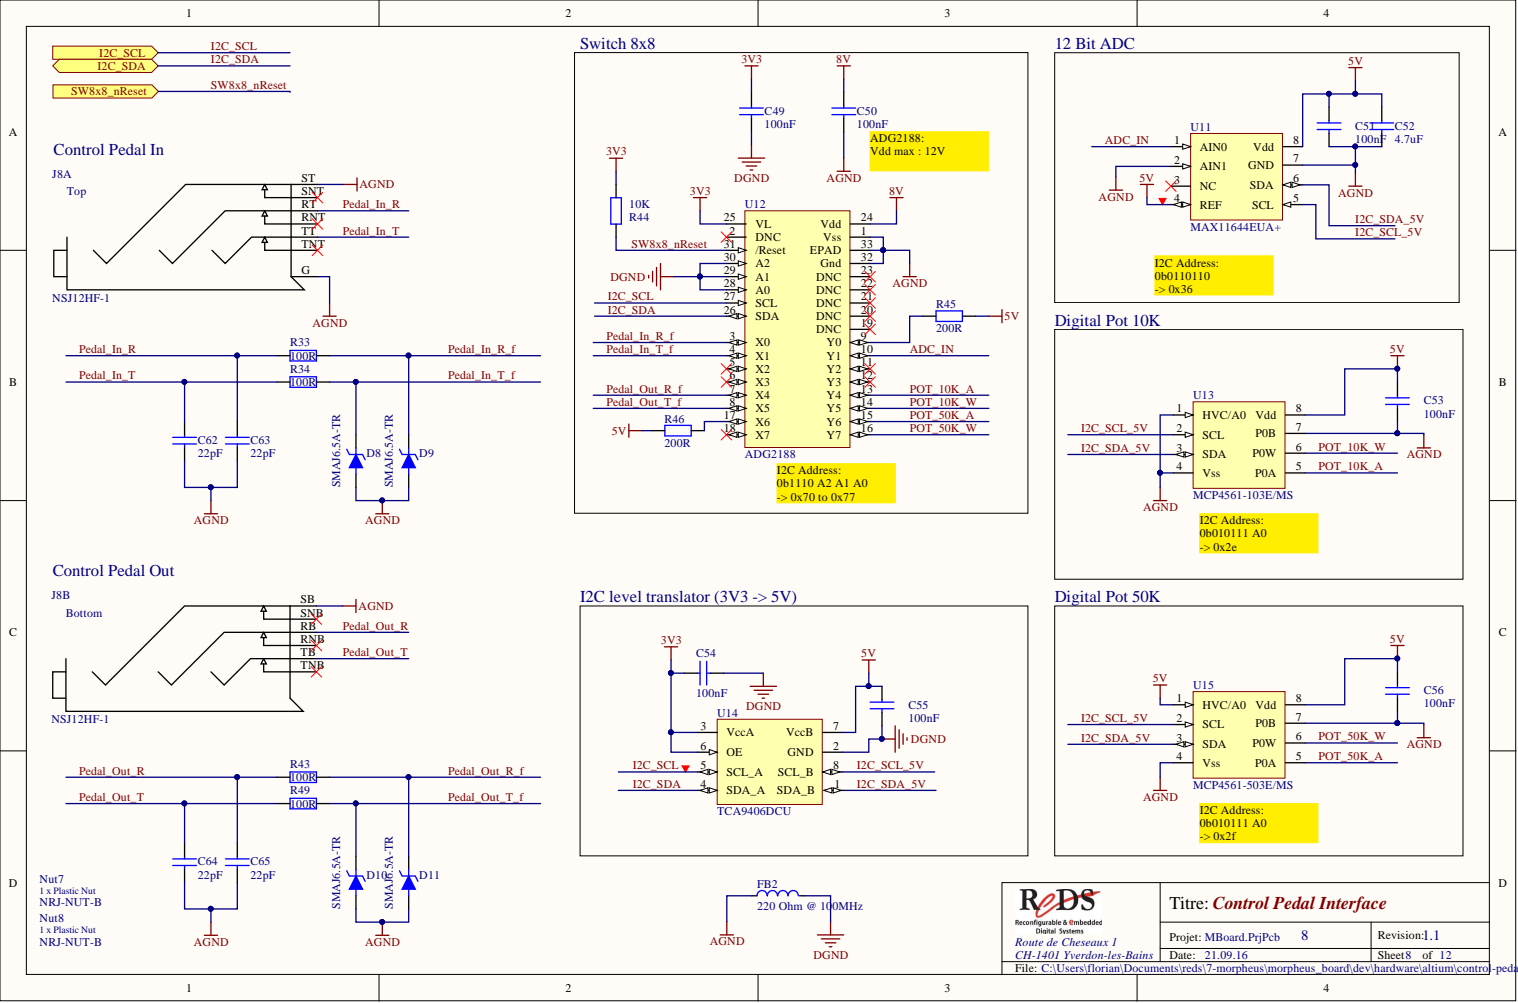
[picture p23: page 8]

AGND

I2C_SDA_5V

C:\Users\florian\Documents\reds\7-morpheus\morpheus_board\dev\hardware\altium\control-pedal.SchDoc

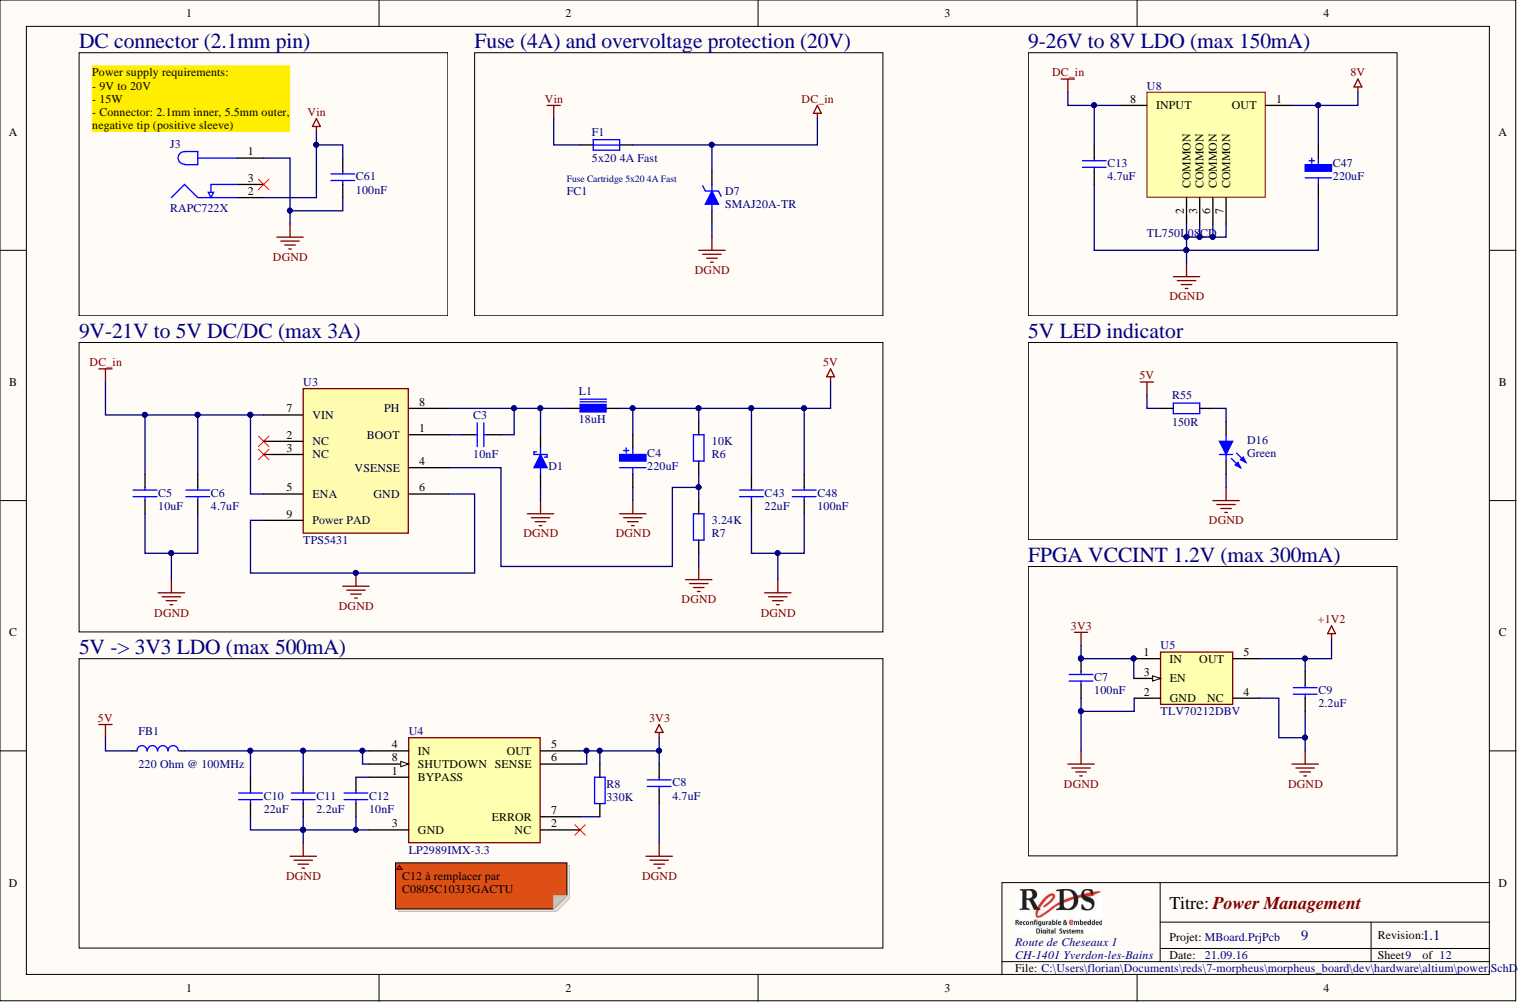
[picture p24: page 9]

Fuse (4A) and overvoltage protection (20V)

Power supply requirements:
- Connector: 2.1mm inner, 5.5mm outer,
negative tip (positive sleeve)

9V-21V to 5V DC/DC (max 3A)

C:\Users\florian\Documents\reds\7-morpheus\morpheus_board\dev\hardware\altium\power.SchDoc

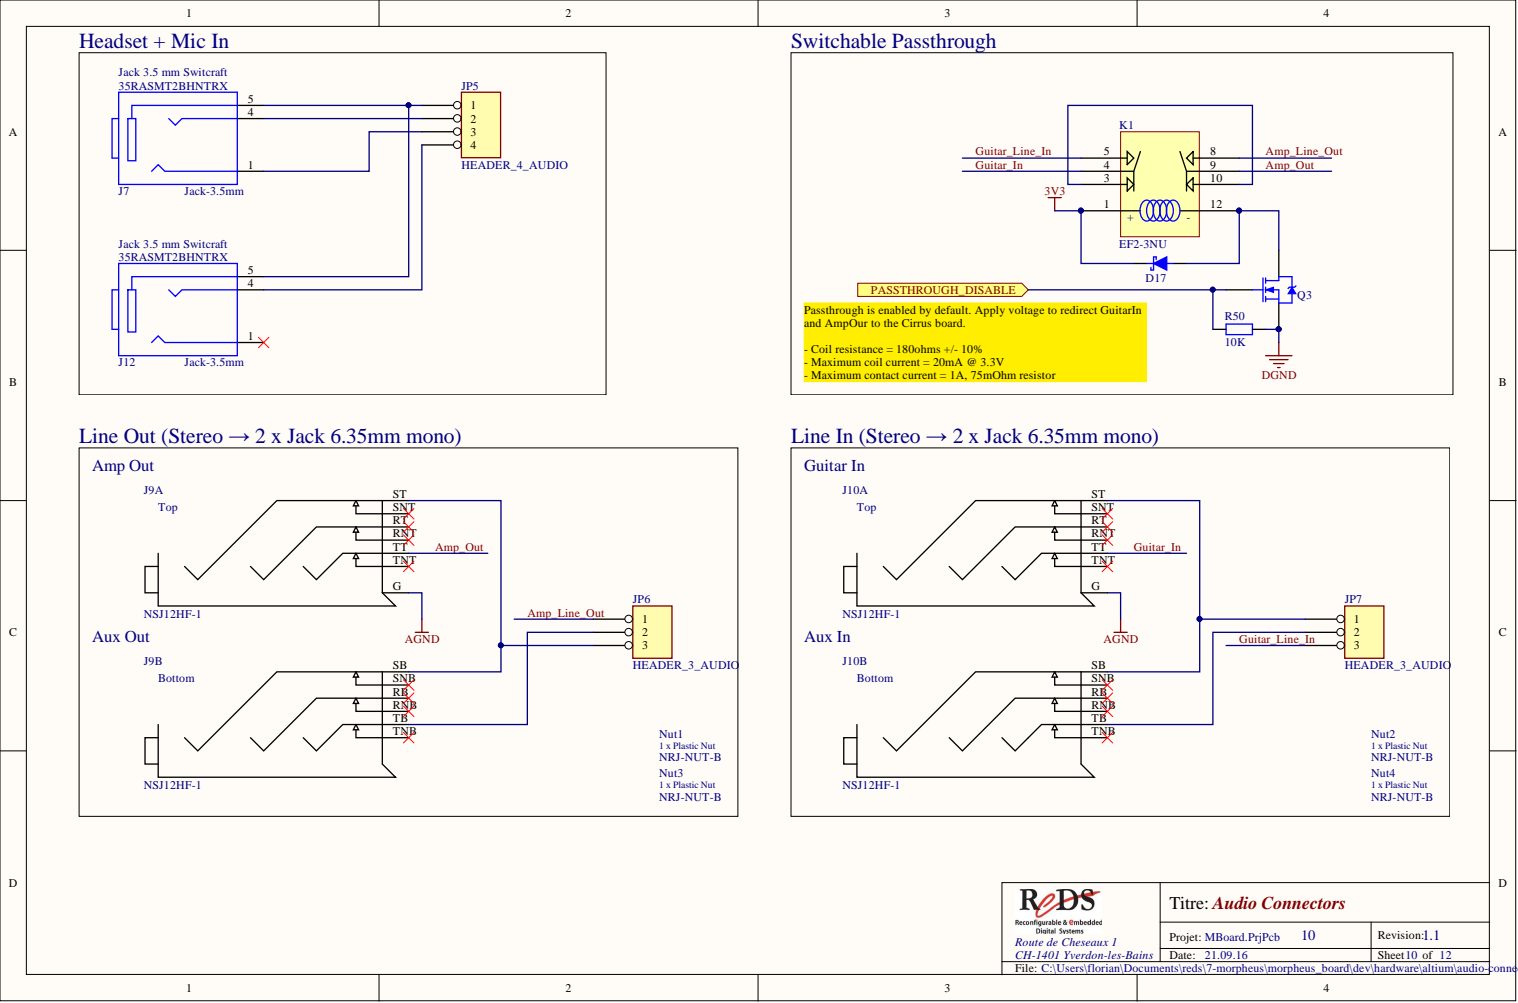
[picture p25: page 10]

Passthrough is enabled by default. Apply voltage to redirect GuitarIn
and AmpOur to the Cirrus board.

- Coil resistance = 180ohms +/- 10%
- Maximum coil current = 20mA @ 3.3V
- Maximum contact current = 1A, 75mOhm resistor

C:\Users\florian\Documents\reds\7-morpheus\morpheus_board\dev\hardware\altium\audio-connectors.SchDoc

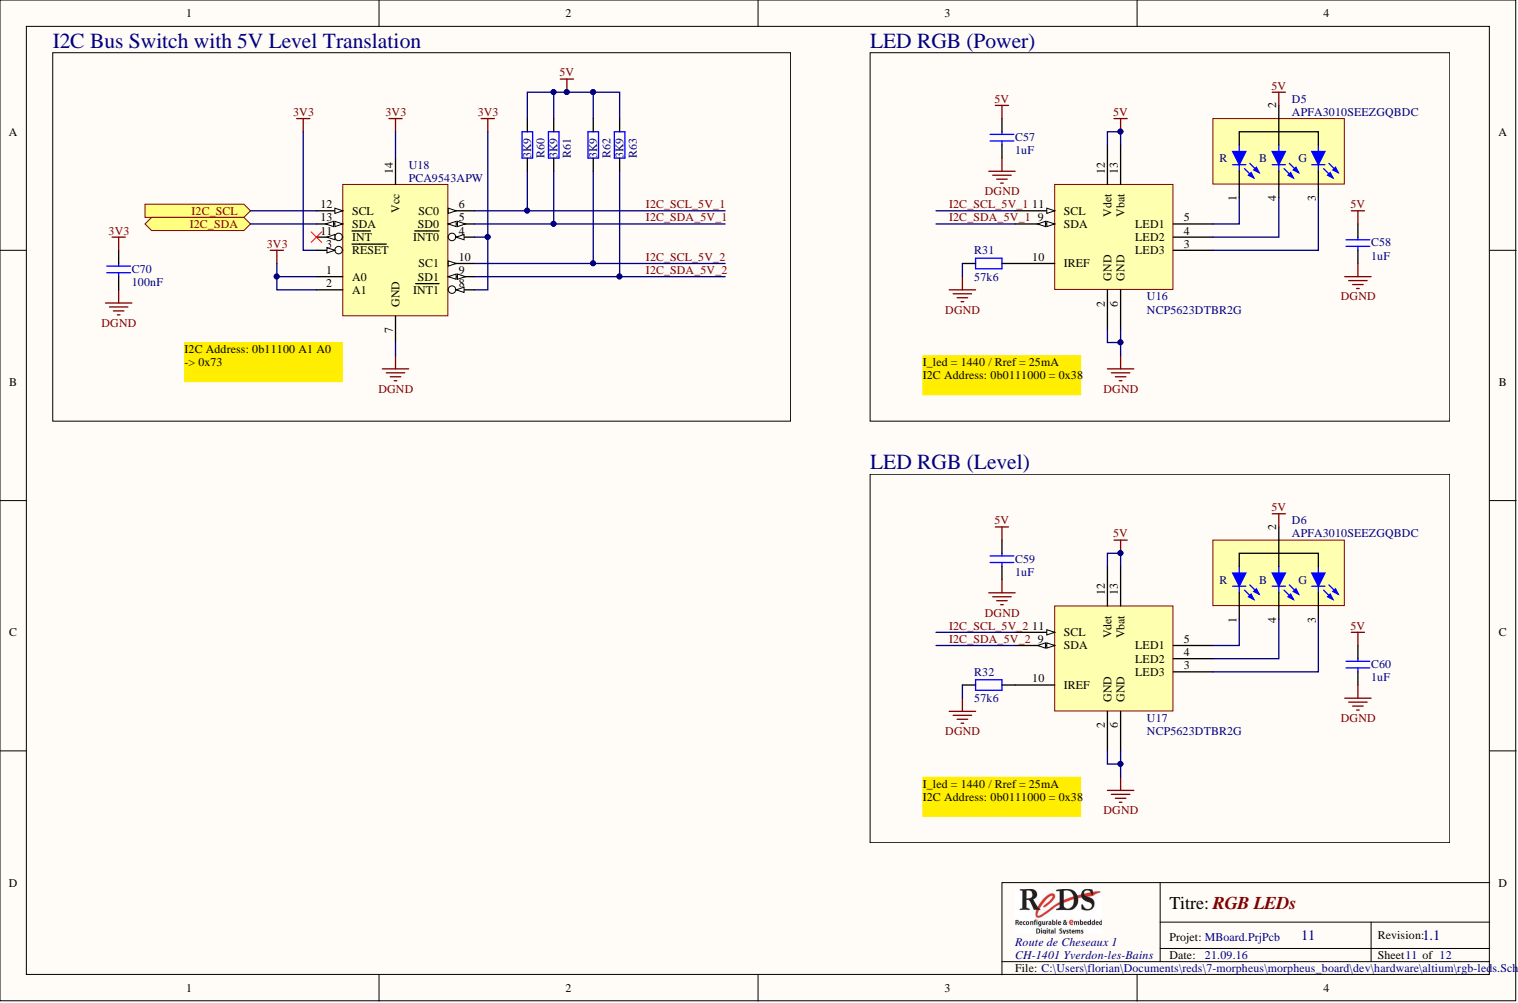
[picture p26: page 11]

I2C Bus Switch with 5V Level Translatio

R o u te de Chesea ux 1 CH-1 1 Yverd o n-les-B a i n s | RGB LED s

Projet : MBoard.PrjPcb | Rev i s i o n : 1.1

1.0 9.1 | Sheet o f

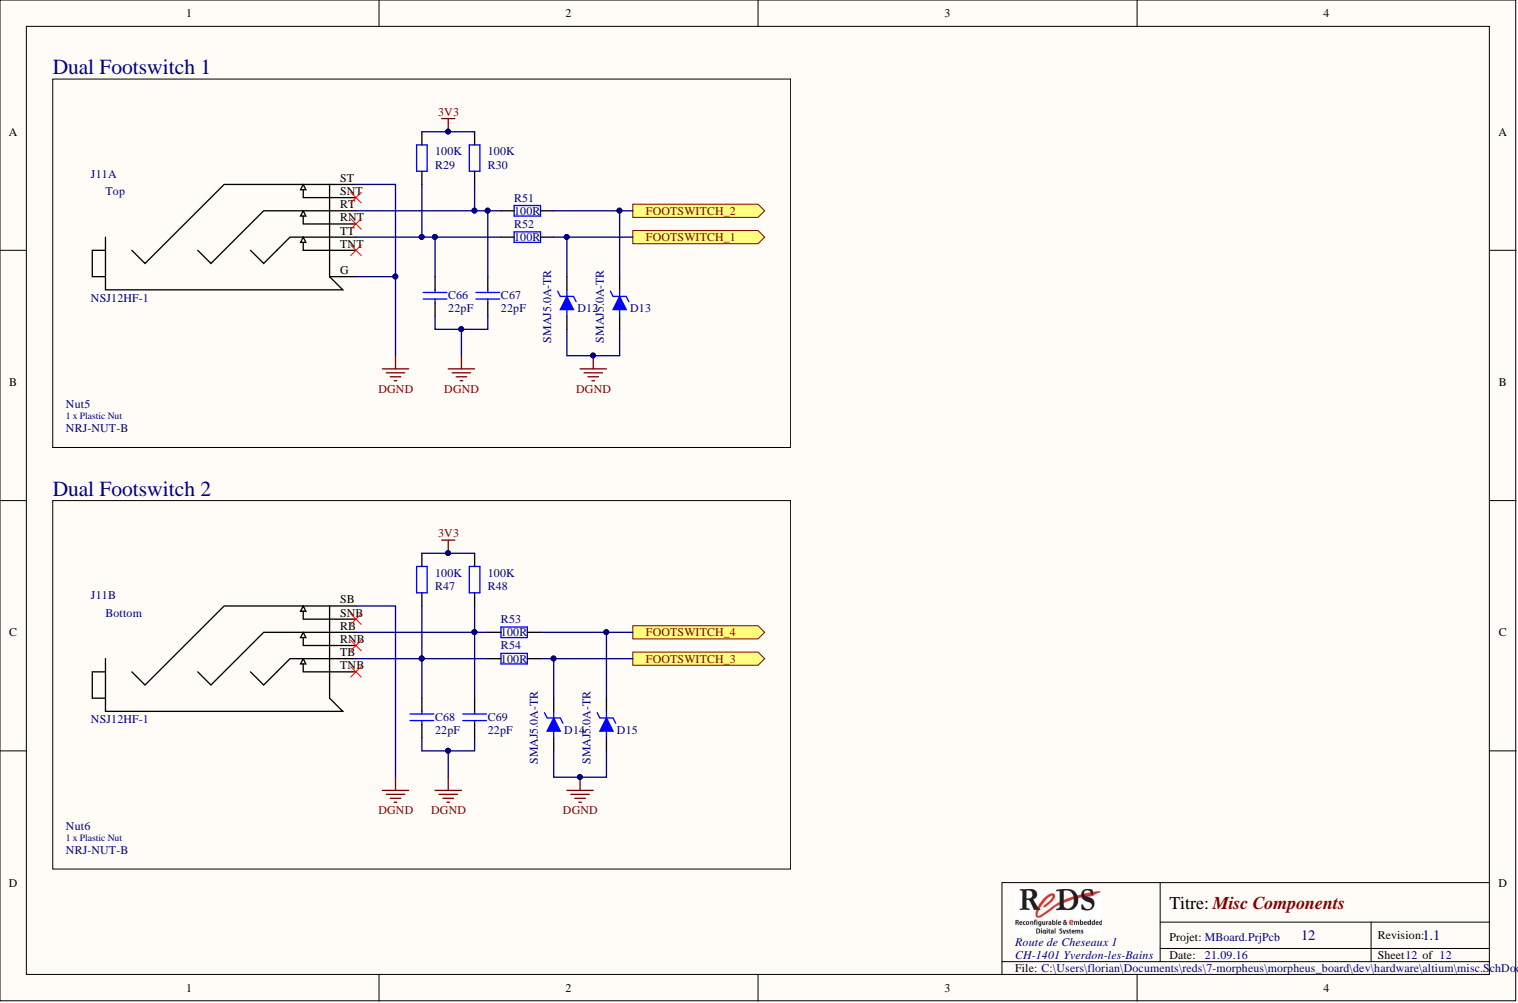
[picture p27: page 12]

C:\Users\florian\Documents\reds\7-morpheus\morpheus_board\dev\hardware\altium\misc.SchDoc
