alejandro11k/Democracy/hardware/board-v1.1/2-assembly/MBoard-ASM.PDF

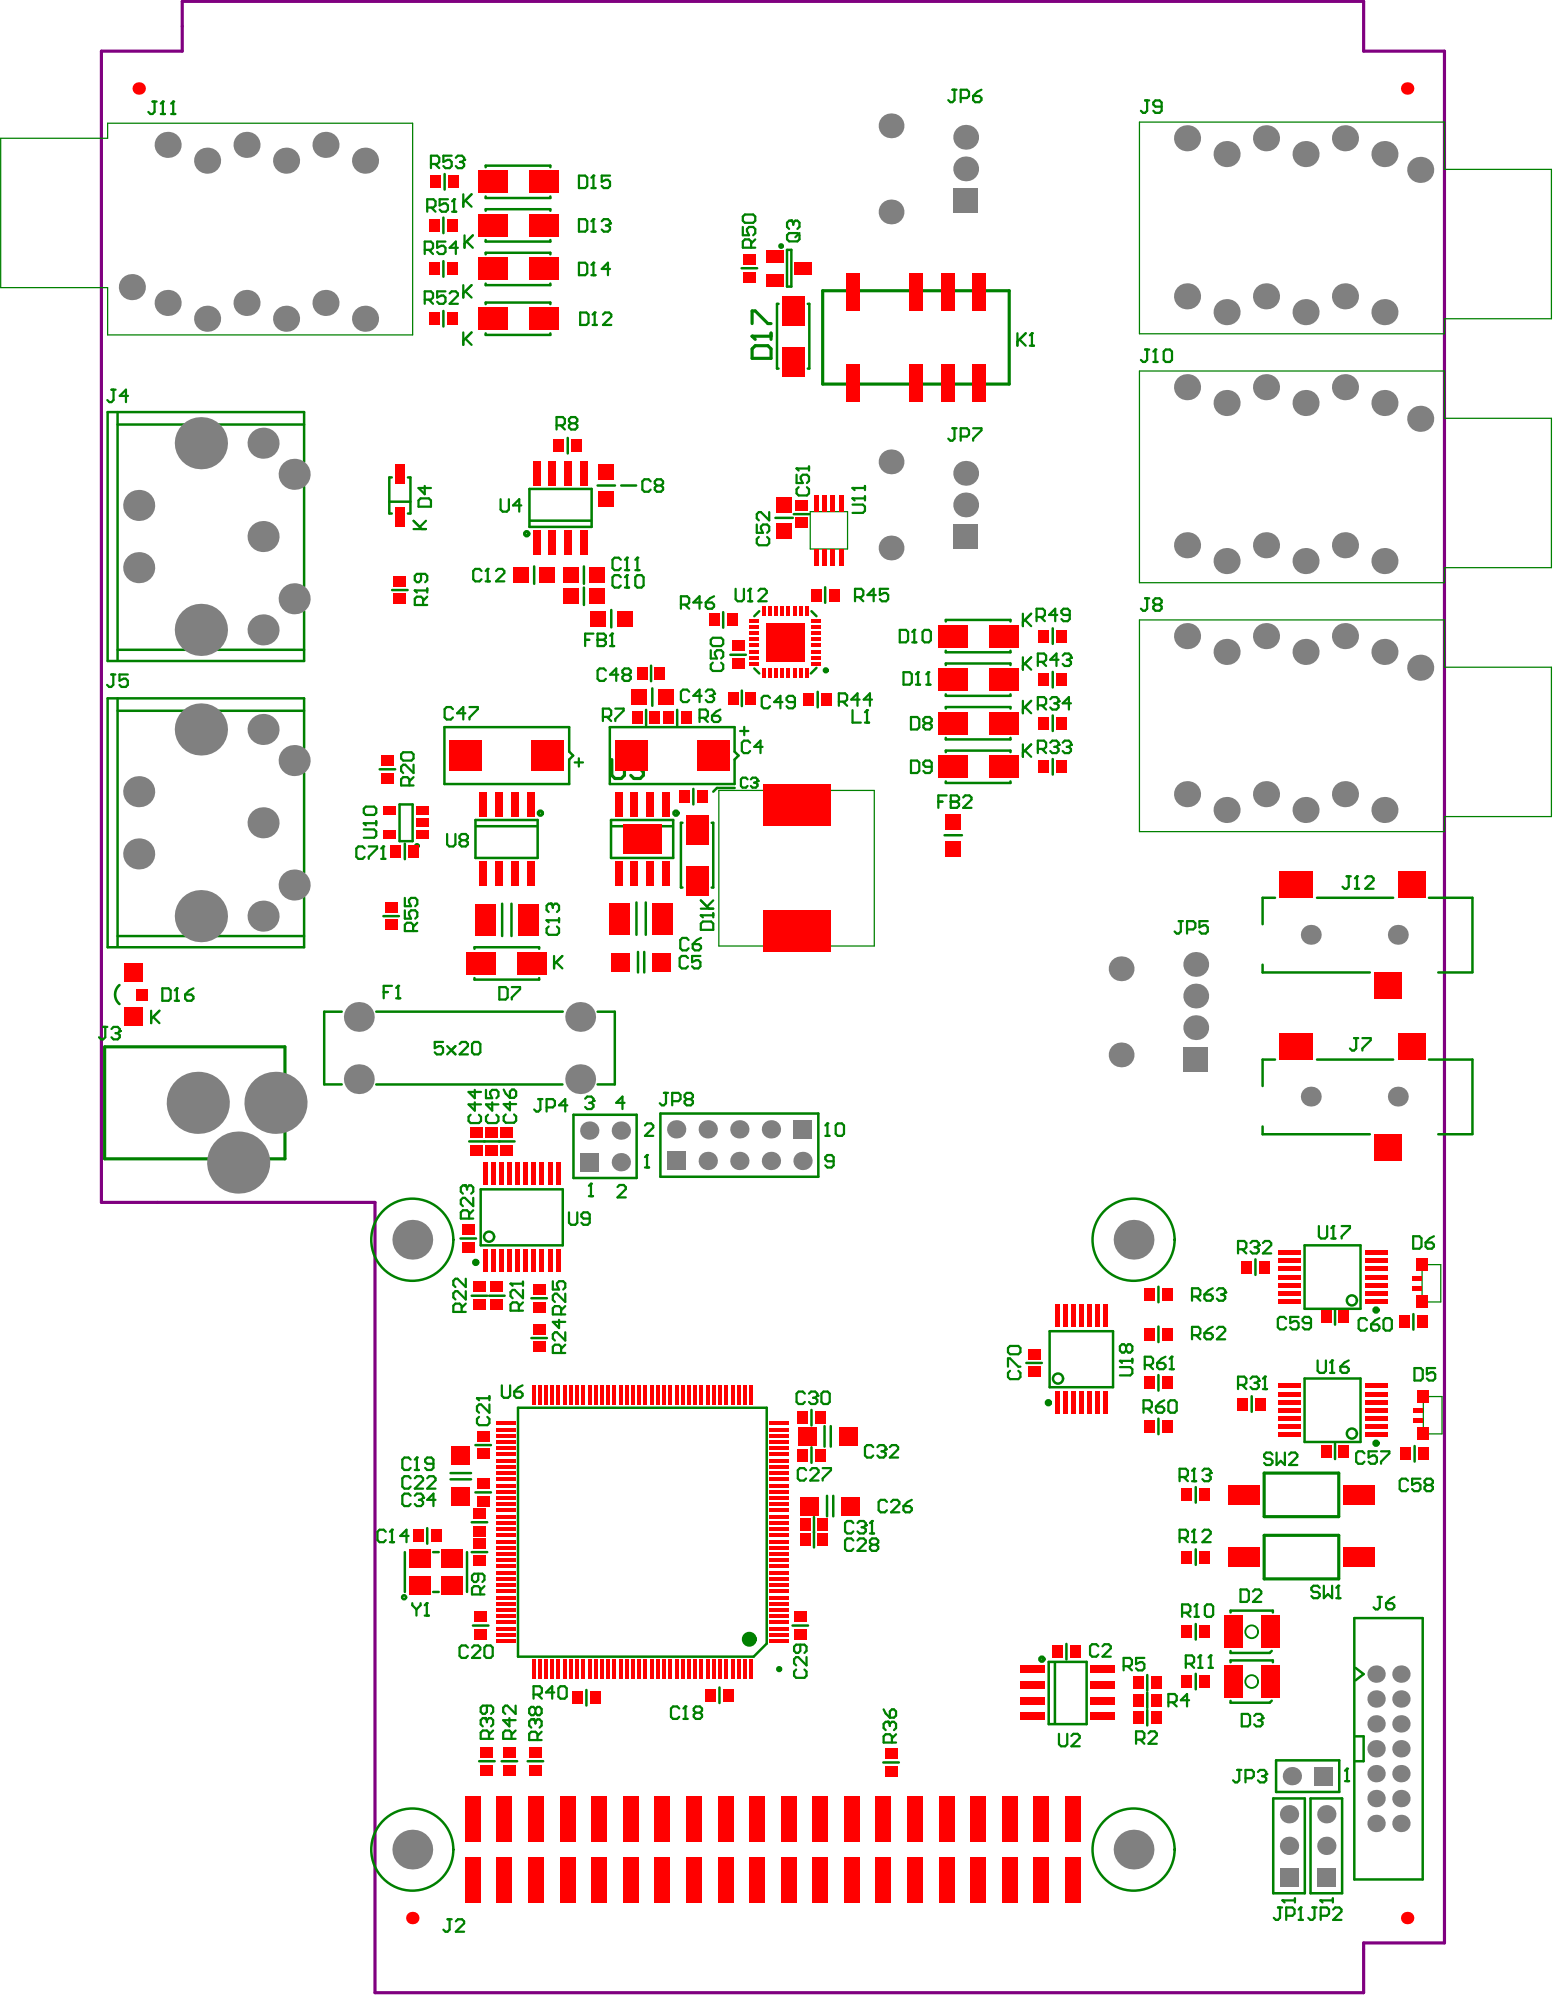
[picture p31: page 1]

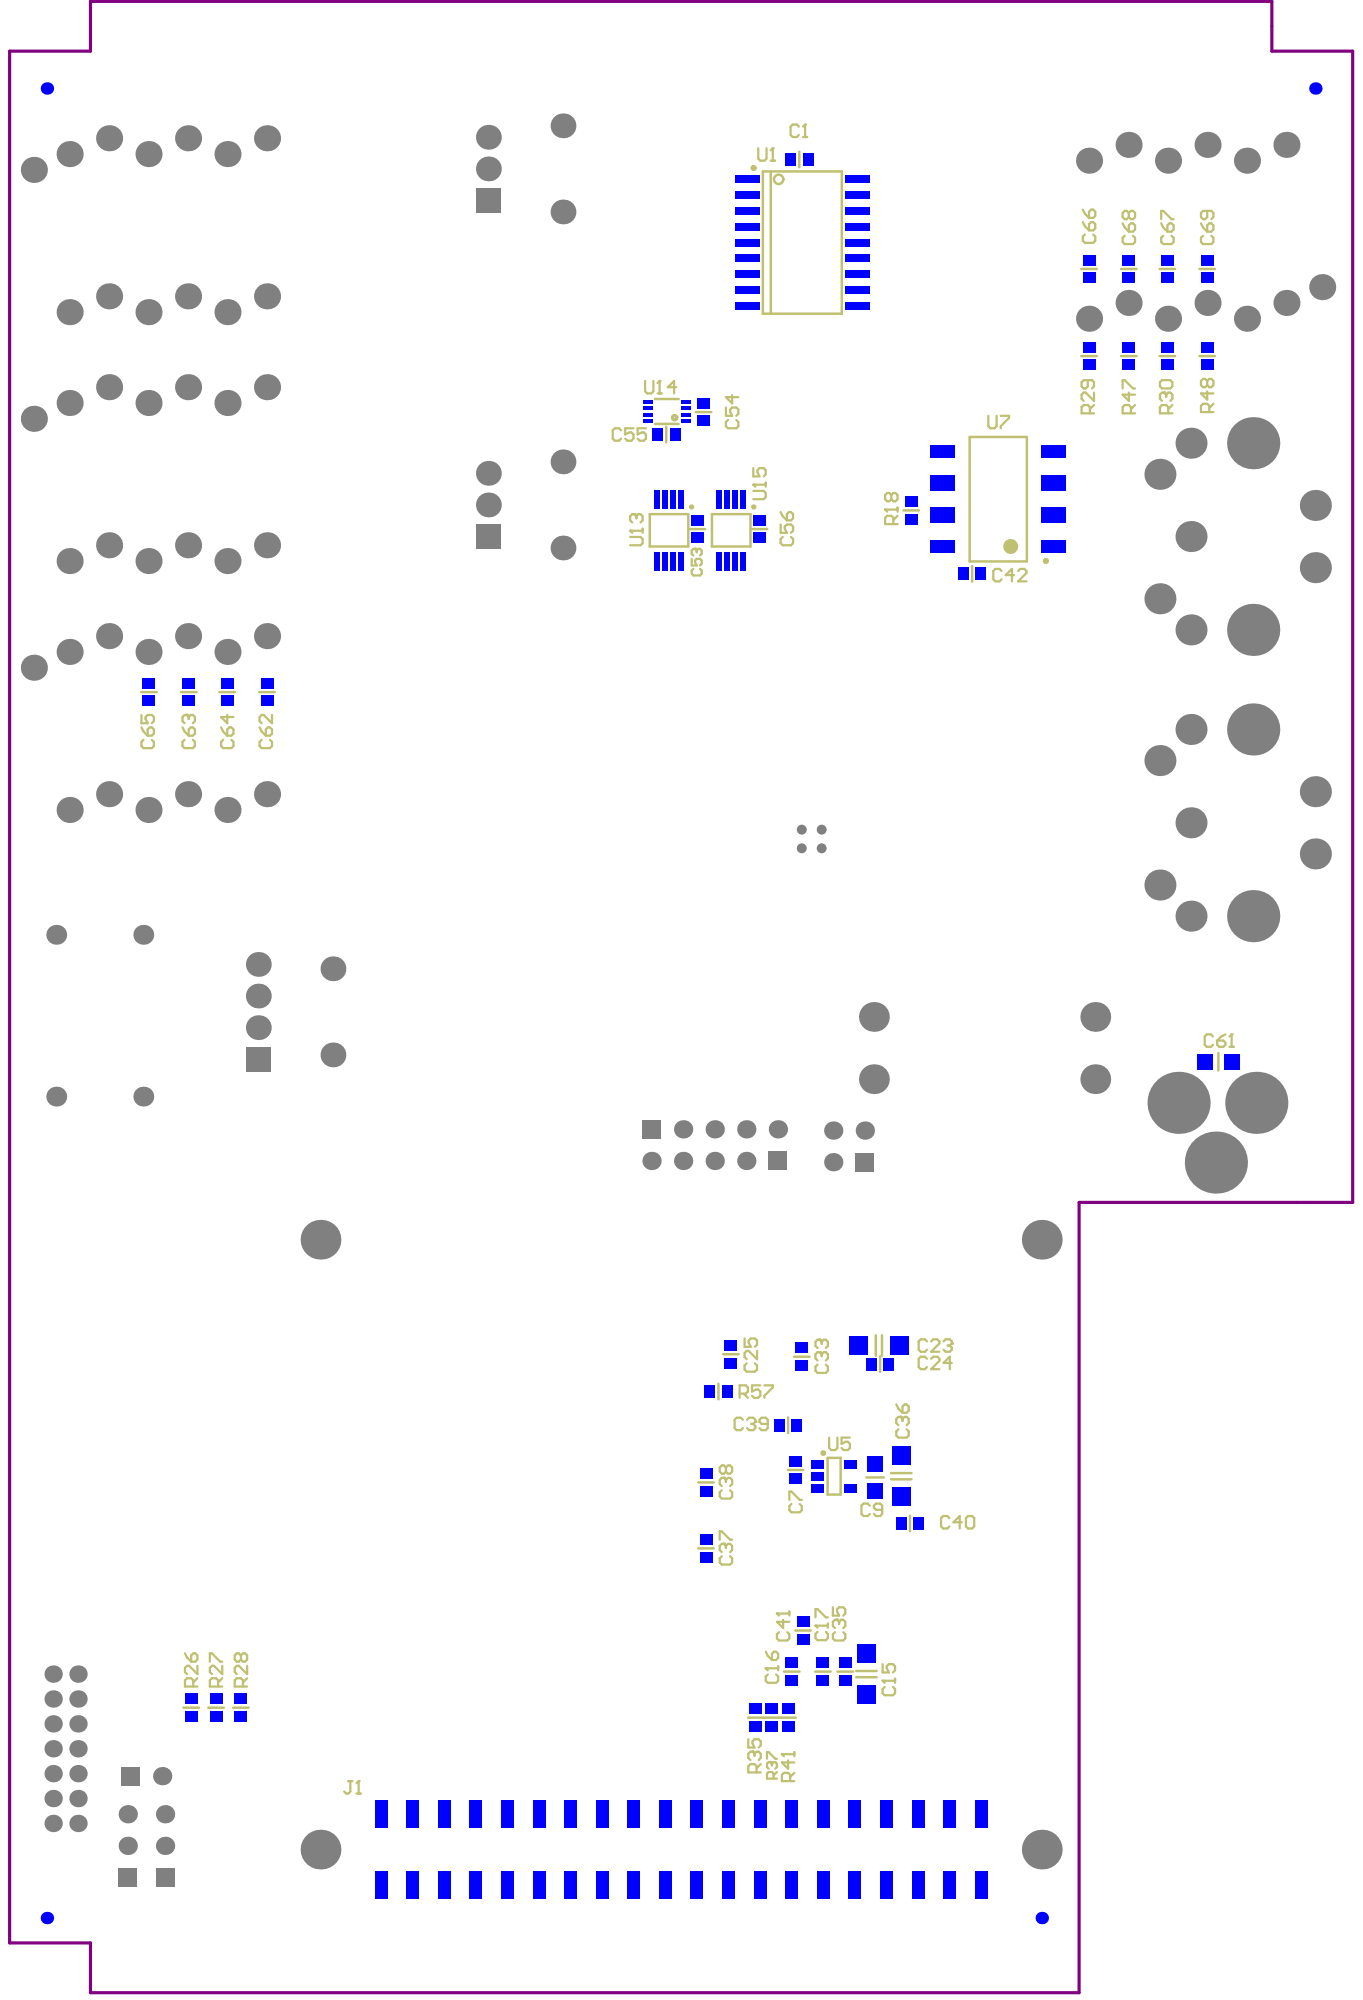
[picture p32: page 2]
