alejandro11k/Democracy/hardware/components/connectors/Jack/Drawing+NRJ6HM-1.pdf

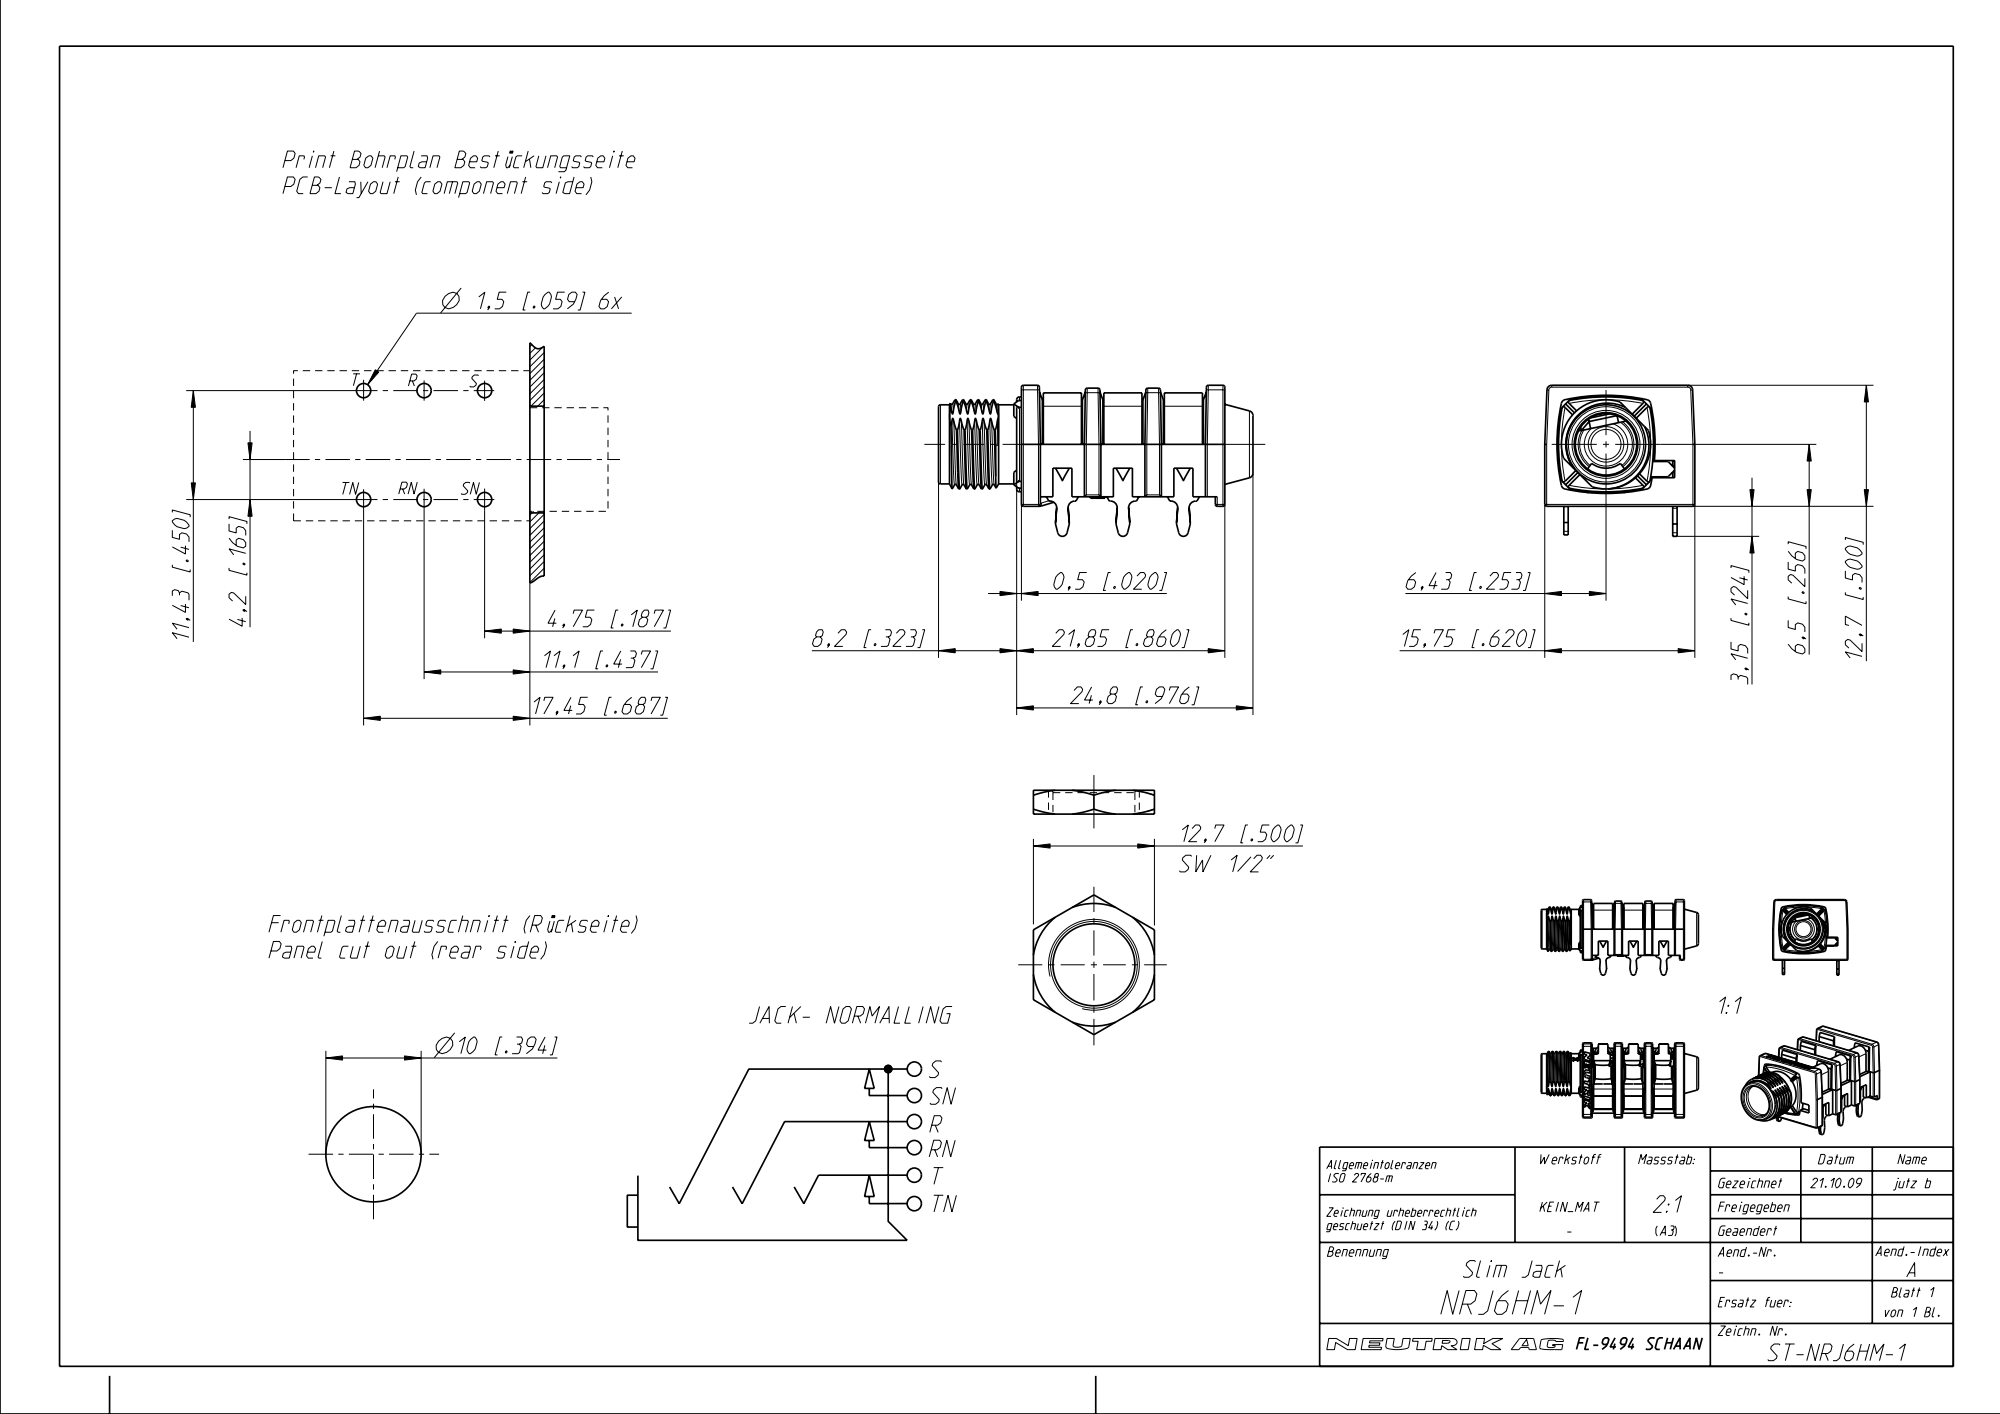
[picture p33: page 1]
