alejandro11k/Democracy/hardware/components/enclosures/Bopla/84168100_ABD-1680.pdf

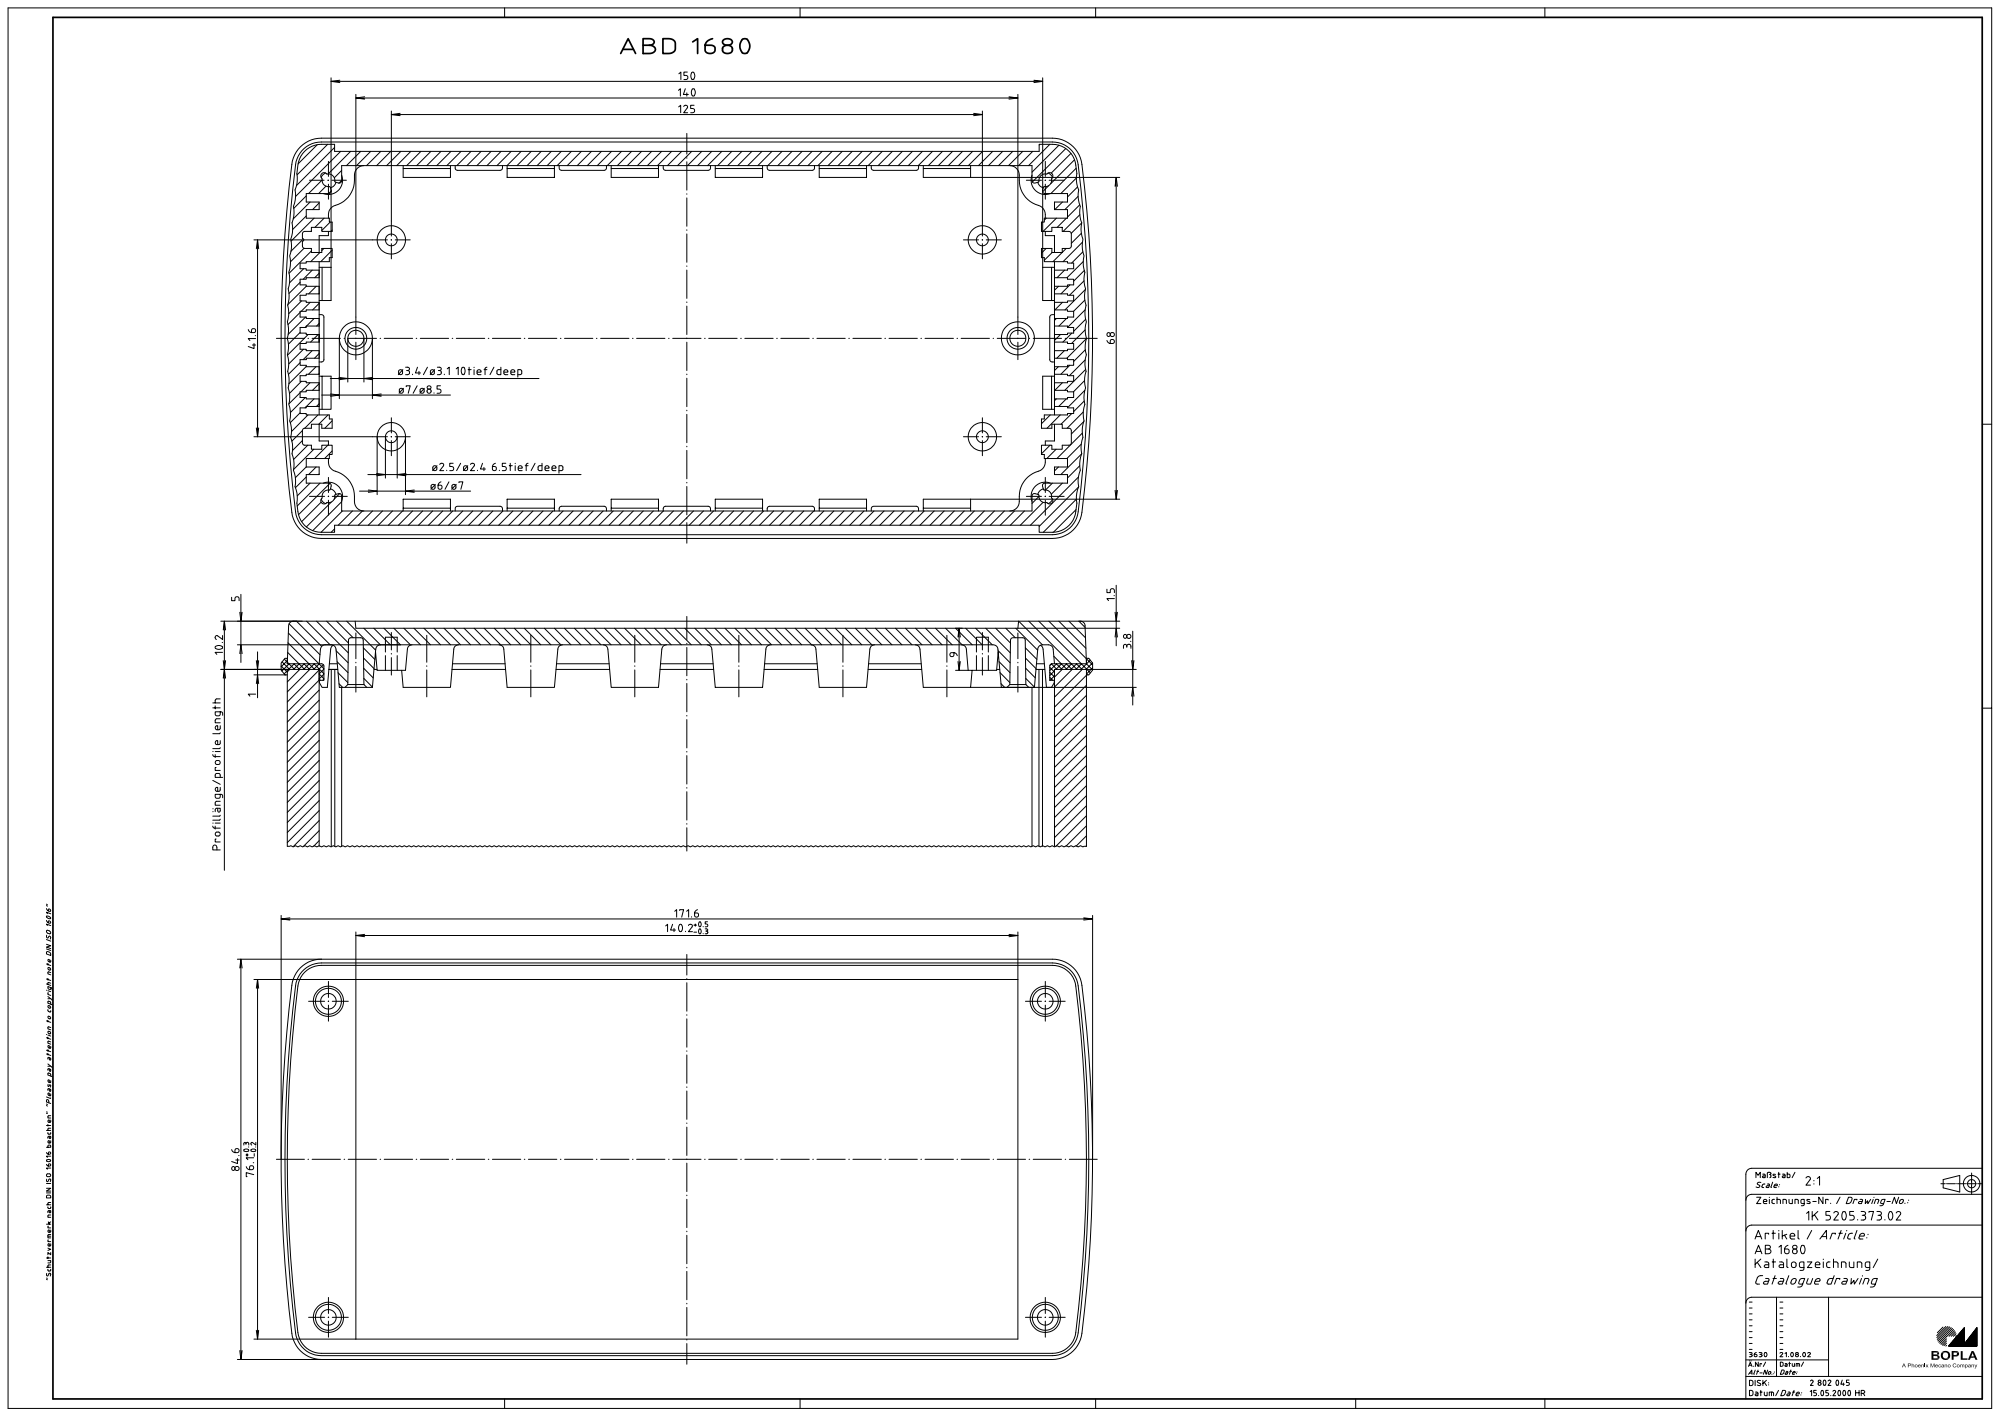
[picture p34: page 1]
