alejandro11k/Democracy/hardware/components/enclosures/Bopla/84686100_ABPH-1680-0100.pdf

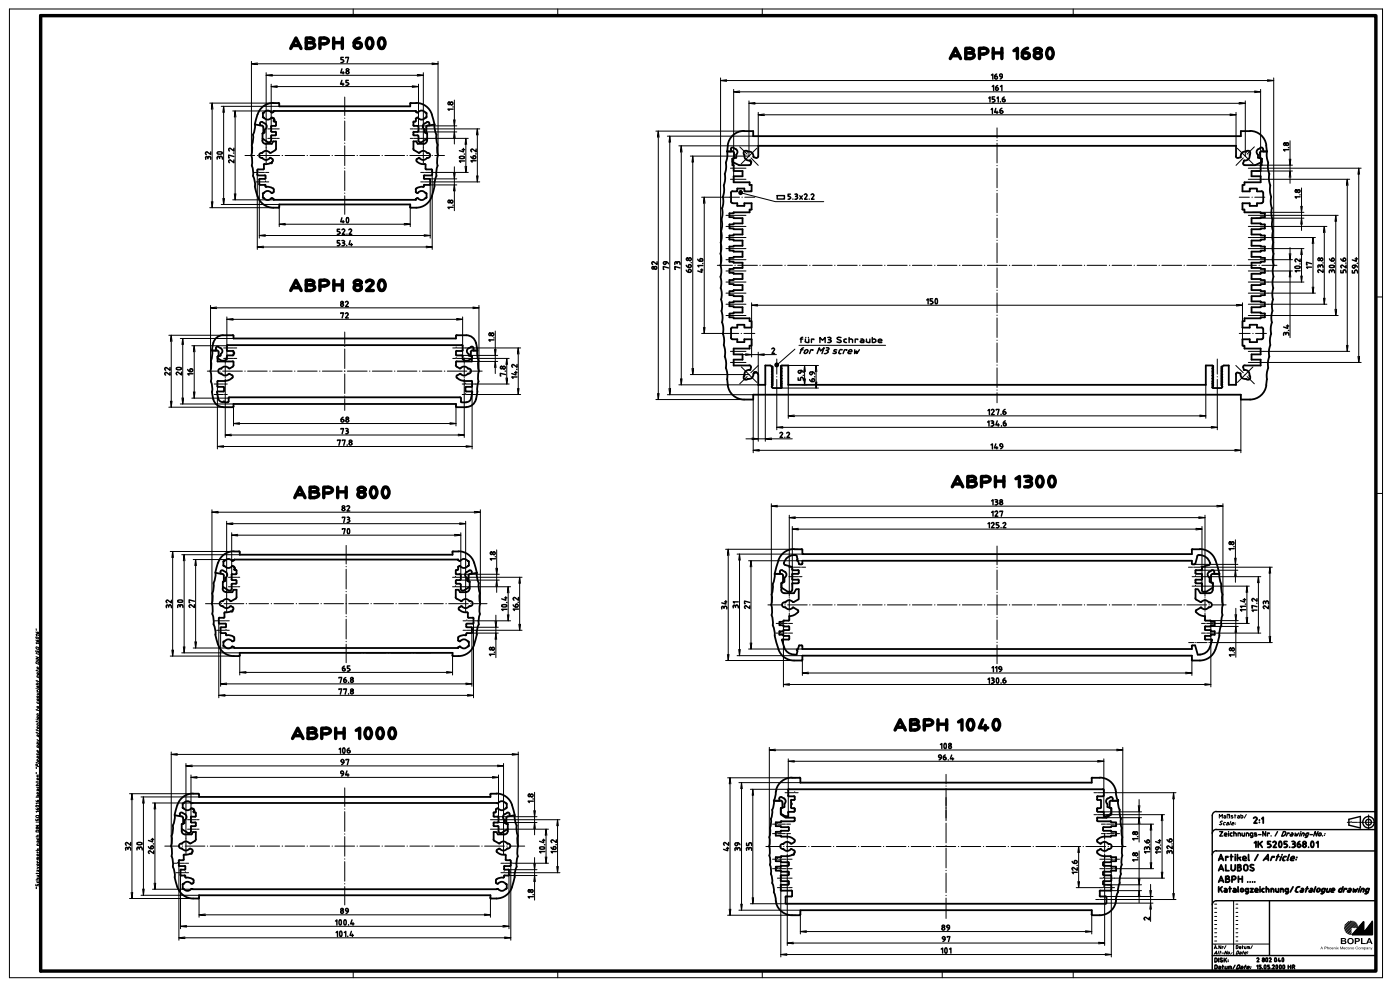
[picture p35: page 1]
