alejandro11k/Democracy/(list of files, drawings)

Other design files:
hardware/altium/audio-connectors.SchDoc
hardware/altium/cirrus-audio.SchDoc
hardware/altium/control-pedal.SchDoc
hardware/altium/fpga-prom.SchDoc
hardware/altium/fpga.SchDoc
hardware/altium/interfaces.SchDoc
hardware/altium/jtag.SchDoc
hardware/altium/MBoard.PcbLib
hardware/altium/MBoard.PrjPcb
hardware/altium/mboard.SchDoc
hardware/altium/MBoard.SchLib
hardware/altium/midi.SchDoc
hardware/altium/misc.SchDoc
hardware/altium/power.SchDoc
hardware/altium/rgb-leds.SchDoc
hardware/altium/rpi.SchDoc
