alejandro11k/Democracy/software/sd-card/boot/config.txt

# For more options and information see
# http://www.raspberrypi.org/documentation/configuration/config-txt.md
# Some settings may impact device functionality. See link above for details

kernel=kernel-morpheus.img

#uncomment to overclock the arm. 700 MHz is the default.
#arm_freq=800

enable_uart=1
init_uart_clock=39062500
init_uart_baud=38400
dtparam=uart0_clkrate=48000000

# Uncomment some or all of these to enable the optional hardware interfaces
#dtparam=i2c_arm=on
#dtparam=i2s=on
#dtparam=spi=on

dtoverlay=rpi-cirrus-wm5102
dtoverlay=i2s-mmap
dtoverlay=rpi-morpheus
dtoverlay=pi3-miniuart-bt
dtoverlay=spi-fpgamorpheus

# Enable access to EEPROM on i2c0 from Linux
dtparam=i2c0=on

dtparam=uart0=on
dtparam=uart1=on
core_freq=250		# this is needed to make the BT work with mini-uart
force_turbo=1

# Enable audio (loads snd_bcm2835)
#dtparam=audio=on
