alejandro11k/Democracy/(commit log)

2016-10-30 added hardware design files and board software
    [3D+File+NMJ6HFD2.stp, 3D+File+NRJ6HM-1.stp, 3D+File+NSJ12HF-1.stp, 84168100_ABD-1680.stp, 84686100_ABPH-1680-0100.dxf, 84686100_ABPH-1680-0100.stp, APFA3010.STEP, HLE-120-02-L-DV.stp]
2016-12-08 updated and added new documentation material
